braingeneers/picroscope-supplement/CADs/README.md

Here are the .STL files for the picroscope. 
Base x1 
Elevator x1 
limit swtich x1 
camerarow x4 
camera insert x24 
led 1 and led 2 x1 
xystage x1 
picroscope wide x1
