braingeneers/picroscope-supplement/PCBs/README.txt

Power distribution board -> V8
Relay hub -> V3R1 -> JLCPCB
Below light -> V6 -> JLCPCB
Overhead light -> R5 -> PCBWAY
