braingeneers/picroscope-supplement/PCBs/below_light/v6/jlc_bom.csv

Comment | Designator | Footprint | LCSC Part #（optional）
LED | LED5 | CHIP-LED0603 | C389521
LED | LED6 | CHIP-LED0603 | C389521
LED | LED7 | CHIP-LED0603 | C389521
LED | LED8 | CHIP-LED0603 | C389521
LED | LED9 | CHIP-LED0603 | C389521
LED | LED10 | CHIP-LED0603 | C389521
LED | LED11 | CHIP-LED0603 | C389521
LED | LED12 | CHIP-LED0603 | C389521
LED | LED13 | CHIP-LED0603 | C389521
LED | LED14 | CHIP-LED0603 | C389521
LED | LED15 | CHIP-LED0603 | C389521
LED | LED16 | CHIP-LED0603 | C389521
LED | LED17 | CHIP-LED0603 | C389521
LED | LED18 | CHIP-LED0603 | C389521
LED | LED19 | CHIP-LED0603 | C389521
LED | LED20 | CHIP-LED0603 | C389521
LED | LED21 | CHIP-LED0603 | C389521
LED | LED22 | CHIP-LED0603 | C389521
LED | LED23 | CHIP-LED0603 | C389521
LED | LED24 | CHIP-LED0603 | C389521
LED | LED25 | CHIP-LED0603 | C389521
LED | LED26 | CHIP-LED0603 | C389521
LED | LED27 | CHIP-LED0603 | C389521
LED | LED28 | CHIP-LED0603 | C389521
LED | LED29 | CHIP-LED0603 | C389521
LED | LED30 | CHIP-LED0603 | C389521
LED | LED31 | CHIP-LED0603 | C389521
LED | LED32 | CHIP-LED0603 | C389521
LED | LED33 | CHIP-LED0603 | C389521
LED | LED34 | CHIP-LED0603 | C389521
LED | LED35 | CHIP-LED0603 | C389521
LED | LED36 | CHIP-LED0603 | C389521
LED | LED37 | CHIP-LED0603 | C389521
LED | LED38 | CHIP-LED0603 | C389521
LED | LED39 | CHIP-LED0603 | C389521
LED | LED40 | CHIP-LED0603 | C389521
LED | LED45 | CHIP-LED0603 | C389521
LED | LED46 | CHIP-LED0603 | C389521
LED | LED47 | CHIP-LED0603 | C389521
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
Resistor | R400 | R0603 | C22775
Resistor | R405 | R0603 | C22775
Resistor | R406 | R0603 | C22775
Resistor | R407 | R0603 | C22775
Resistor | R408 | R0603 | C22775
Resistor | R413 | R0603 | C22775
Resistor | R414 | R0603 | C22775
Resistor | R415 | R0603 | C22775
Resistor | R416 | R0603 | C22775
