braingeneers/picroscope-supplement/PCBs/encoder_uno_shield/without-debounce-v1.0/jlcpcb-assembly-files/shield board_top_bom.csv

Comment | Designator | Footprint | LCSC Part #
0.1uF | C1 | C0603
1k | R3 | R0603
10k | R4 | R0603
