braingeneers/picroscope-supplement/PCBs/power_distribution/pinheader_v8/PCBWay/Mid/mid_bom.xlsx

 | Column1 | Column12 | Column2 | Column3 | Column4 | Column5
Item# | *Designator | Qty | Manufacturer | *Mfg Part # | *Package/Footprint | Description
1 | C13 | 1 | Nichicon | UHE1E331MPD6 | E3,5-8 | POLARIZED CAPACITOR 330uF, 25V, American symbol
1 | C14 | 1 | Nichicon | UHE1E331MPD6 | E3,5-8 | POLARIZED CAPACITOR 330uF, 25V, American symbol
1 | C15 | 1 | Nichicon | UHE1E331MPD6 | E3,5-8 | POLARIZED CAPACITOR 330uF, 25V, American symbol
1 | C16 | 1 | Nichicon | UHE1E331MPD6 | E3,5-8 | POLARIZED CAPACITOR 330uF, 25V, American symbol
1 | U$1 | 1 | Sullins Connector Solutions | SFH11-PBPC-D20-RA-BK | RASPI_GPIO_B+_PIN | CONN HDR 40POS 0.1 GOLD PCB R/A
1 | U$2 | 1 | Sullins Connector Solutions | SFH11-PBPC-D20-RA-BK | RASPI_GPIO_B+_PIN | CONN HDR 40POS 0.1 GOLD PCB R/A
1 | U$3 | 1 | Sullins Connector Solutions | SFH11-PBPC-D20-RA-BK | RASPI_GPIO_B+_PIN | CONN HDR 40POS 0.1 GOLD PCB R/A
1 | U$4 | 1 | Sullins Connector Solutions | SFH11-PBPC-D20-RA-BK | RASPI_GPIO_B+_PIN | CONN HDR 40POS 0.1 GOLD PCB R/A
1 | U$5 | 1 | Sullins Connector Solutions | SFH11-PBPC-D20-RA-BK | RASPI_GPIO_B+_PIN | CONN HDR 40POS 0.1 GOLD PCB R/A
1 | U$6 | 1 | Sullins Connector Solutions | SFH11-PBPC-D20-RA-BK | RASPI_GPIO_B+_PIN | CONN HDR 40POS 0.1 GOLD PCB R/A
1 | U$7 | 1 | Sullins Connector Solutions | SFH11-PBPC-D20-RA-BK | RASPI_GPIO_B+_PIN | CONN HDR 40POS 0.1 GOLD PCB R/A
1 | U$8 | 1 | Sullins Connector Solutions | SFH11-PBPC-D20-RA-BK | RASPI_GPIO_B+_PIN | CONN HDR 40POS 0.1 GOLD PCB R/A
1 | U$9 | 1 | Sullins Connector Solutions | SFH11-PBPC-D20-RA-BK | RASPI_GPIO_B+_PIN | CONN HDR 40POS 0.1 GOLD PCB R/A
1 | U$10 | 1 | Sullins Connector Solutions | SFH11-PBPC-D20-RA-BK | RASPI_GPIO_B+_PIN | CONN HDR 40POS 0.1 GOLD PCB R/A
1 | U$11 | 1 | Sullins Connector Solutions | SFH11-PBPC-D20-RA-BK | RASPI_GPIO_B+_PIN | CONN HDR 40POS 0.1 GOLD PCB R/A
1 | U$12 | 1 | Sullins Connector Solutions | SFH11-PBPC-D20-RA-BK | RASPI_GPIO_B+_PIN | CONN HDR 40POS 0.1 GOLD PCB R/A
1 | U$13 | 1 | MOLEX | 39301022 | MINI-FIT_JR_CONN
1 | U$14 | 1 | MOLEX | 39301022 | MINI-FIT_JR_CONN
1 | U$15 | 1 | MOLEX | 39301022 | MINI-FIT_JR_CONN
1 | U$16 | 1 | MOLEX | 39301022 | MINI-FIT_JR_CONN
