braingeneers/picroscope-supplement/PCBs/pi_relay_hub/v3r2/picrocope_hub_v3r2.csv

C1 | 54.48 | 27.81 | 0 | 0.1uF | C0603
C2 | 28.84 | 38.13 | 270 | 47 uF | C1210
C3 | 58.29 | 27.81 | 0 | 0.1uF | C0603
C4 | 46.46 | 24.04 | 270 | 47 uF | C1210
C5 | 28.68 | 24.13 | 270 | 47 uF | C1210
C6 | 28.70 | 30.48 | 0 | 100pF | C0603
C7 | 46.49 | 38.17 | 270 | 47 uF | C1210
C8 | 28.96 | 44.45 | 0 | 100pF | C0603
C9 | 46.48 | 9.53 | 270 | 47 uF | C1210
C10 | 28.83 | 9.53 | 270 | 47 uF | C1210
C11 | 28.83 | 15.75 | 0 | 100pF | C0603
D1 | -16.26 | 45.97 | 270 | 1N4148 | LL-34
D2 | 5.33 | 45.97 | 270 | 1N4148 | LL-34
D3 | -26.42 | 45.97 | 270 | 1N4148 | LL-34
D4 | -37.85 | 45.97 | 270 | 1N4148 | LL-34
D5 | -6.10 | 45.97 | 270 | 1N4148 | LL-34
D6 | 16.76 | 45.97 | 270 | 1N4148 | LL-34
Q1 | 9.14 | 46.02 | 0 | 600mA/40V | SOT23-3
Q2 | -12.45 | 46.02 | 0 | 600mA/40V | SOT23-3
Q3 | -22.61 | 46.02 | 0 | 600mA/40V | SOT23-3
Q4 | -34.04 | 46.02 | 0 | 600mA/40V | SOT23-3
Q5 | -2.29 | 46.02 | 0 | 600mA/40V | SOT23-3
Q6 | 20.57 | 46.02 | 0 | 600mA/40V | SOT23-3
R1 | 9.14 | 42.16 | 180 | 1k | R0603
R2 | -12.45 | 42.16 | 180 | 1k | R0603
R3 | -22.61 | 42.16 | 180 | 1k | R0603
R4 | -34.04 | 42.16 | 180 | 1k | R0603
R5 | 54.48 | 23.75 | 180 | 1k | R0603
R6 | 54.48 | 25.78 | 0 | 10k | R0603
R7 | 28.96 | 46.99 | 0 | 2.727k | R0603
R8 | 28.70 | 33.02 | 0 | 2.727k | R0603
R9 | 58.29 | 23.75 | 180 | 1k | R0603
R10 | 58.29 | 25.78 | 0 | 10k | R0603
R11 | -2.29 | 42.16 | 180 | 1k | R0603
R12 | 28.67 | 28.03 | 0 | 330 | R0603
R13 | 28.96 | 42.16 | 0 | 330 | R0603
R14 | 20.57 | 42.16 | 180 | 1k | R0603
R15 | 28.83 | 18.29 | 0 | 2.727k | R0603
R16 | 28.83 | 13.46 | 0 | 330 | R0603
TP1 | 26.16 | 10.92 | 0 | PTR1B1 | 27 | B1 | 27
TP2 | 25.91 | 27.69 | 0 | PTR1B1 | 27 | B1 | 27
TP3 | 26.16 | 39.62 | 0 | PTR1B1 | 27 | B1 | 27
TP4 | 52.07 | 29.46 | 0 | PTR1B1 | 27 | B1 | 27
U$1 | 37.74 | 41.74 | 180 | PVX012A0XV1 | PVX012A0X
U$2 | 37.51 | 27.75 | 180 | PVX012A0XV1 | PVX012A0X
U$4 | 37.46 | 13.08 | 180 | PVX012A0XV1 | PVX012A0X
U$10 | 46.43 | 31.09 | 270 | PTC_1206 | 1206
U$11 | 46.44 | 44.66 | 270 | PTC_1206 | 1206
U$17 | 46.48 | 16.76 | 270 | PTC_1206 | 1206
