braingeneers/picroscope-supplement/PCBs/overhead_light/r5_cleanup_updated_file/24v5_bom.xlsx

Item # | *Designator | *Qty | Manufacturer | *Mfg Part # | Description / Value | *Package/Footprint | Type | Your Instructions / Notes
1 | C1 |  |  |  | 47 uF | C1210 | SMD
2 | C7 |  |  |  | 47 uF | C1210 | SMD
3 | R3 |  |  |  | 4k | R0603 | SMD
4 | RJ1 |  |  |  | 5k | 3223W | SMD
5 | U$1 |  | Chanzon | 10DGL-DZ-3W-WH | high_powered_led_packages__pcb_3w-_100w_arrays |  | SMD | https://www.amazon.com/gp/product/B01DBZICDC/ref=ppx_yo_dt_b_search_asin_title?ie=UTF8&th=1
6 | U$2 |  | Chanzon | 10DGL-DZ-3W-WH | high_powered_led_packages__pcb_3w-_100w_arrays |  | SMD | https://www.amazon.com/gp/product/B01DBZICDC/ref=ppx_yo_dt_b_search_asin_title?ie=UTF8&th=1
7 | U$3 |  | Chanzon | 10DGL-DZ-3W-WH | high_powered_led_packages__pcb_3w-_100w_arrays |  | SMD | https://www.amazon.com/gp/product/B01DBZICDC/ref=ppx_yo_dt_b_search_asin_title?ie=UTF8&th=1
8 | U$4 |  | Chanzon | 10DGL-DZ-3W-WH | high_powered_led_packages__pcb_3w-_100w_arrays |  | SMD | https://www.amazon.com/gp/product/B01DBZICDC/ref=ppx_yo_dt_b_search_asin_title?ie=UTF8&th=1
9 | U$5 |  | Chanzon | 10DGL-DZ-3W-WH | high_powered_led_packages__pcb_3w-_100w_arrays |  | SMD | https://www.amazon.com/gp/product/B01DBZICDC/ref=ppx_yo_dt_b_search_asin_title?ie=UTF8&th=1
10 | U$6 |  | Chanzon | 10DGL-DZ-3W-WH | high_powered_led_packages__pcb_3w-_100w_arrays |  | SMD | https://www.amazon.com/gp/product/B01DBZICDC/ref=ppx_yo_dt_b_search_asin_title?ie=UTF8&th=1
11 | U$7 |  | Chanzon | 10DGL-DZ-3W-WH | high_powered_led_packages__pcb_3w-_100w_arrays |  | SMD | https://www.amazon.com/gp/product/B01DBZICDC/ref=ppx_yo_dt_b_search_asin_title?ie=UTF8&th=1
12 | U$8 |  | Chanzon | 10DGL-DZ-3W-WH | high_powered_led_packages__pcb_3w-_100w_arrays |  | SMD | https://www.amazon.com/gp/product/B01DBZICDC/ref=ppx_yo_dt_b_search_asin_title?ie=UTF8&th=1
13 | U$9 |  | Chanzon | 10DGL-DZ-3W-WH | high_powered_led_packages__pcb_3w-_100w_arrays |  | SMD | https://www.amazon.com/gp/product/B01DBZICDC/ref=ppx_yo_dt_b_search_asin_title?ie=UTF8&th=1
14 | U$10 |  | Chanzon | 10DGL-DZ-3W-WH | high_powered_led_packages__pcb_3w-_100w_arrays |  | SMD | https://www.amazon.com/gp/product/B01DBZICDC/ref=ppx_yo_dt_b_search_asin_title?ie=UTF8&th=1
15 | U$11 |  | Chanzon | 10DGL-DZ-3W-WH | high_powered_led_packages__pcb_3w-_100w_arrays |  | SMD | https://www.amazon.com/gp/product/B01DBZICDC/ref=ppx_yo_dt_b_search_asin_title?ie=UTF8&th=1
16 | U$12 |  | Chanzon | 10DGL-DZ-3W-WH | high_powered_led_packages__pcb_3w-_100w_arrays |  | SMD | https://www.amazon.com/gp/product/B01DBZICDC/ref=ppx_yo_dt_b_search_asin_title?ie=UTF8&th=1
17 | U$13 |  | Chanzon | 10DGL-DZ-3W-WH | high_powered_led_packages__pcb_3w-_100w_arrays |  | SMD | https://www.amazon.com/gp/product/B01DBZICDC/ref=ppx_yo_dt_b_search_asin_title?ie=UTF8&th=1
18 | U$14 |  | Chanzon | 10DGL-DZ-3W-WH | high_powered_led_packages__pcb_3w-_100w_arrays |  | SMD | https://www.amazon.com/gp/product/B01DBZICDC/ref=ppx_yo_dt_b_search_asin_title?ie=UTF8&th=1
19 | U$15 |  | Chanzon | 10DGL-DZ-3W-WH | high_powered_led_packages__pcb_3w-_100w_arrays |  | SMD | https://www.amazon.com/gp/product/B01DBZICDC/ref=ppx_yo_dt_b_search_asin_title?ie=UTF8&th=1
20 | U$16 |  | Chanzon | 10DGL-DZ-3W-WH | high_powered_led_packages__pcb_3w-_100w_arrays |  | SMD | https://www.amazon.com/gp/product/B01DBZICDC/ref=ppx_yo_dt_b_search_asin_title?ie=UTF8&th=1
21 | U$17 |  | Chanzon | 10DGL-DZ-3W-WH | high_powered_led_packages__pcb_3w-_100w_arrays |  | SMD | https://www.amazon.com/gp/product/B01DBZICDC/ref=ppx_yo_dt_b_search_asin_title?ie=UTF8&th=1
22 | U$18 |  | Chanzon | 10DGL-DZ-3W-WH | high_powered_led_packages__pcb_3w-_100w_arrays |  | SMD | https://www.amazon.com/gp/product/B01DBZICDC/ref=ppx_yo_dt_b_search_asin_title?ie=UTF8&th=1
23 | U$19 |  | Chanzon | 10DGL-DZ-3W-WH | high_powered_led_packages__pcb_3w-_100w_arrays |  | SMD | https://www.amazon.com/gp/product/B01DBZICDC/ref=ppx_yo_dt_b_search_asin_title?ie=UTF8&th=1
24 | U$20 |  | Chanzon | 10DGL-DZ-3W-WH | high_powered_led_packages__pcb_3w-_100w_arrays |  | SMD | https://www.amazon.com/gp/product/B01DBZICDC/ref=ppx_yo_dt_b_search_asin_title?ie=UTF8&th=1
25 | U$21 |  | Chanzon | 10DGL-DZ-3W-WH | high_powered_led_packages__pcb_3w-_100w_arrays |  | SMD | https://www.amazon.com/gp/product/B01DBZICDC/ref=ppx_yo_dt_b_search_asin_title?ie=UTF8&th=1
26 | U$22 |  | Chanzon | 10DGL-DZ-3W-WH | high_powered_led_packages__pcb_3w-_100w_arrays |  | SMD | https://www.amazon.com/gp/product/B01DBZICDC/ref=ppx_yo_dt_b_search_asin_title?ie=UTF8&th=1
27 | U$23 |  | Chanzon | 10DGL-DZ-3W-WH | high_powered_led_packages__pcb_3w-_100w_arrays |  | SMD | https://www.amazon.com/gp/product/B01DBZICDC/ref=ppx_yo_dt_b_search_asin_title?ie=UTF8&th=1
28 | U$24 |  | Chanzon | 10DGL-DZ-3W-WH | high_powered_led_packages__pcb_3w-_100w_arrays |  | SMD | https://www.amazon.com/gp/product/B01DBZICDC/ref=ppx_yo_dt_b_search_asin_title?ie=UTF8&th=1
29 | U$25 |  | ABB Power Electronics Inc. | PVX012A0X3-SRZ | DC DC CONVERTER 0.6-5.5V 66W | 17-SMD Module | SMD | https://www.digikey.com/en/products/detail/abb-power-electronics-inc/PVX012A0X3-SRZ/2601261
