braingeneers/picroscope-supplement/CADs/camera_holder/camera_holder_middle_left.stl

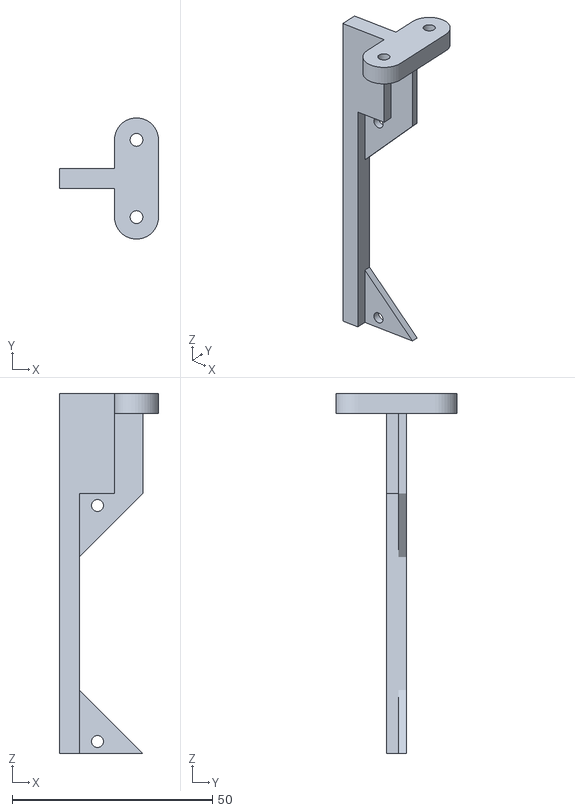
[picture p1: CAD file, 2022-08-23]
CADs/camera_holder/camera_holder_middle_left.stl
24.8 x 30.3 x 90.0
