braingeneers/picroscope-supplement/CADs/limitswitch_front.stl

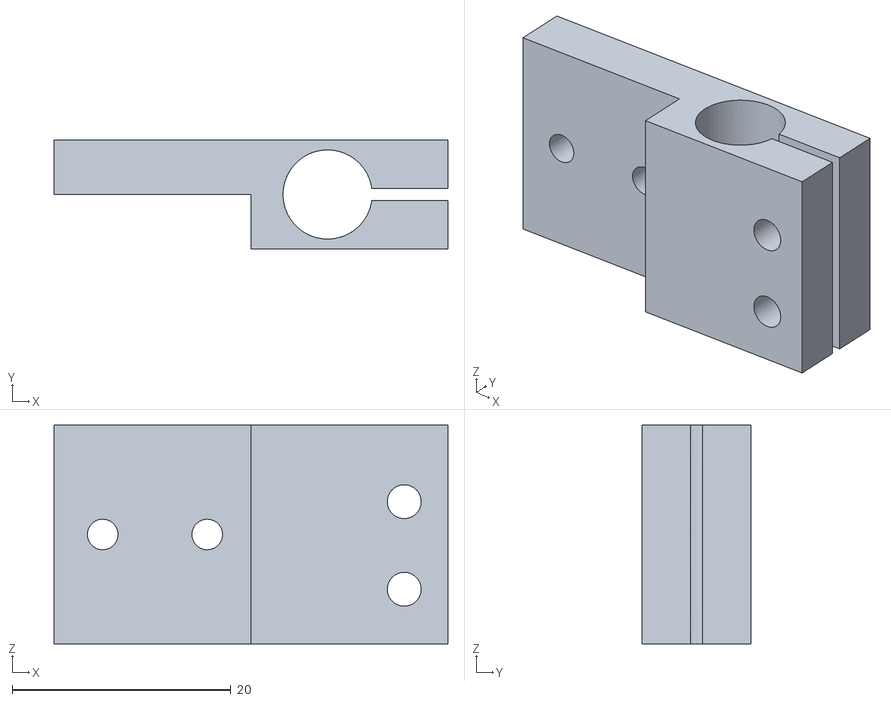
[picture p2: CAD file, 2022-08-23]
CADs/limitswitch_front.stl
36.0 x 10.0 x 20.0
