braingeneers/picroscope-supplement/CADs/XY_stage/XY_Y_axis_adjust.stl

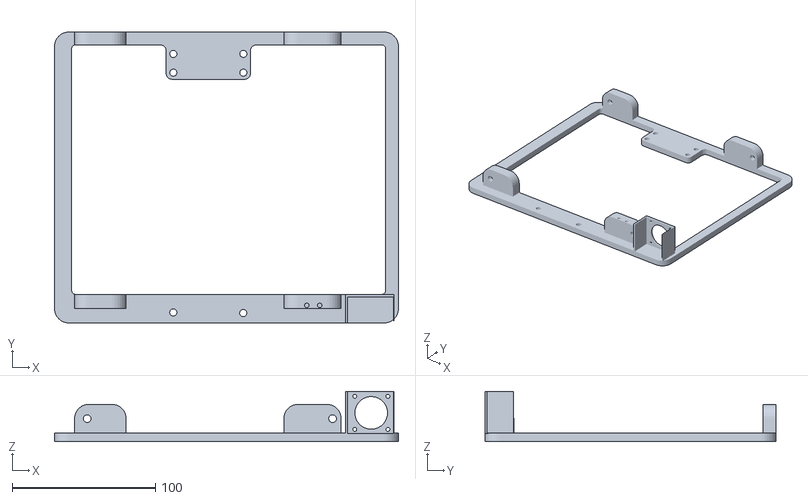
[picture p3: CAD file, 2022-08-23]
CADs/XY_stage/XY_Y_axis_adjust.stl
240.0 x 203.0 x 35.0
