braingeneers/picroscope-supplement/CADs/camera_holder/camera_holder_left.stl

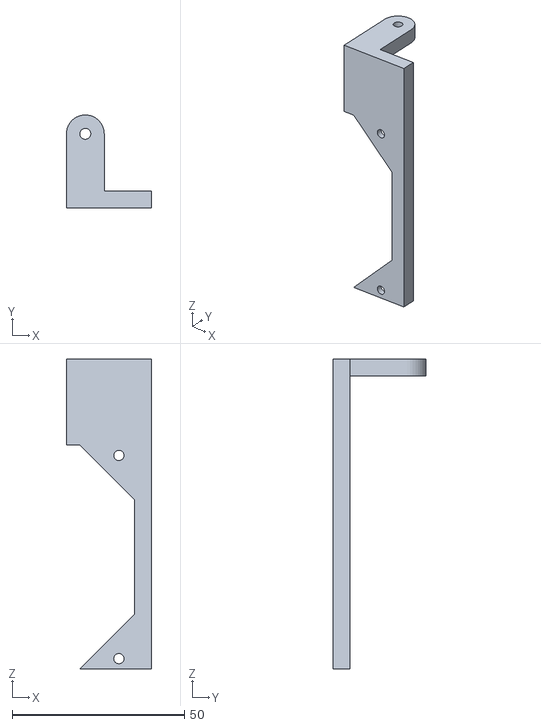
[picture p4: CAD file, 2022-08-23]
CADs/camera_holder/camera_holder_left.stl
24.8 x 27.0 x 90.0
