braingeneers/picroscope-supplement/CADs/Elevator.stl

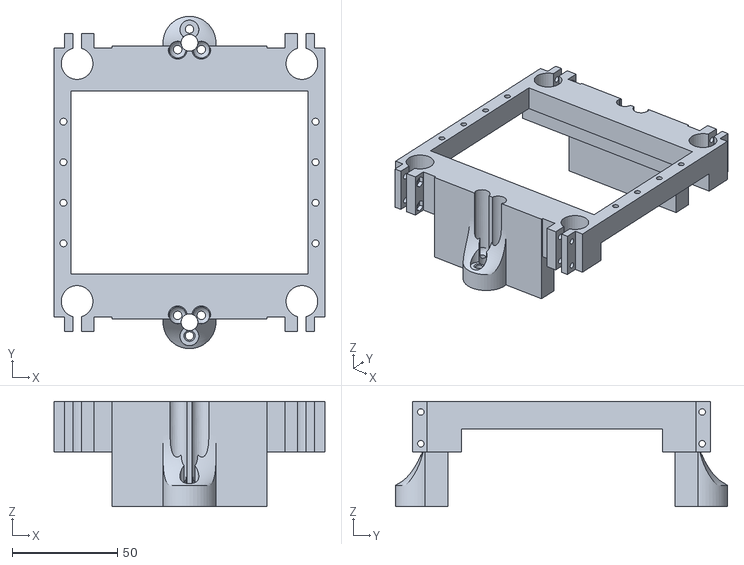
[picture p5: CAD file, 2022-08-23]
CADs/Elevator.stl
129.0 x 158.2 x 50.0
