braingeneers/picroscope-supplement/CADs/XY_stage/XY_X_axis_adjust.stl

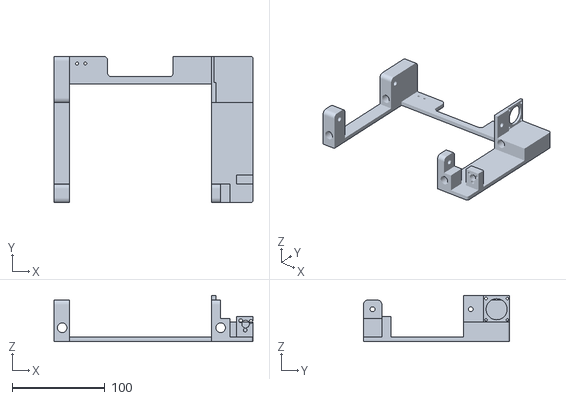
[picture p6: CAD file, 2022-08-23]
CADs/XY_stage/XY_X_axis_adjust.stl
215.0 x 158.0 x 50.0
