braingeneers/picroscope-supplement/CADs/base_linear.stl

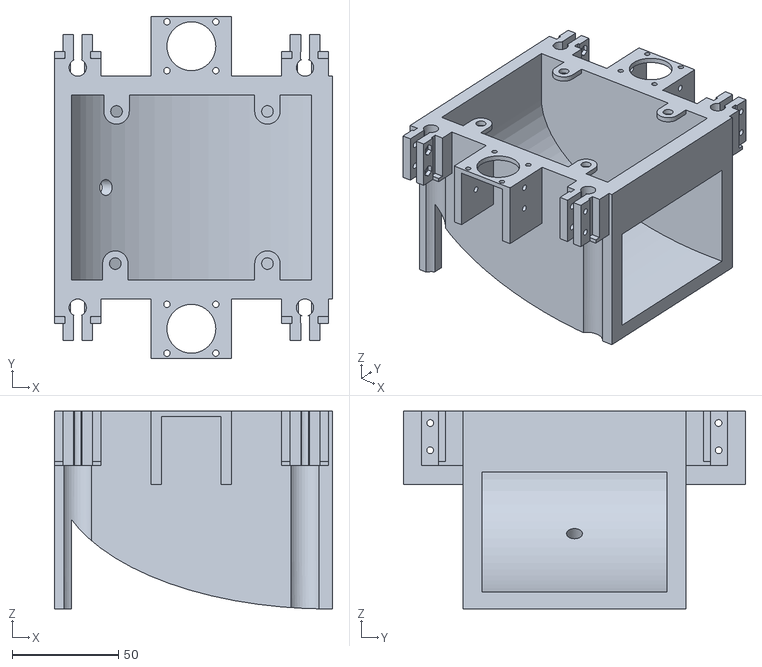
[picture p7: CAD file, 2022-08-23]
CADs/base_linear.stl
131.0 x 161.0 x 93.1
