braingeneers/picroscope-supplement/CADs/XY_stage/XY_plate_holder.stl

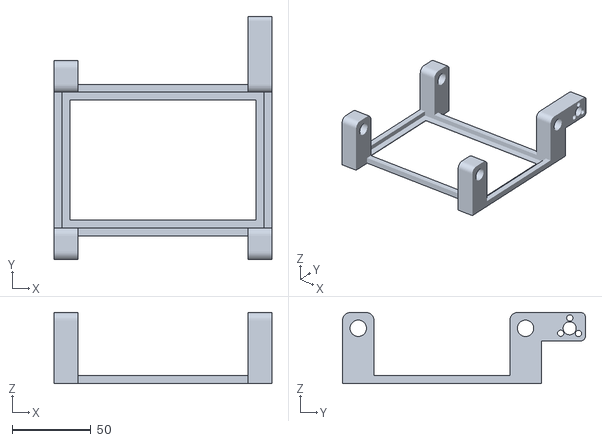
[picture p8: CAD file, 2022-08-23]
CADs/XY_stage/XY_plate_holder.stl
138.0 x 154.0 x 45.0
