braingeneers/picroscope-supplement/CADs/camera_clip.stl

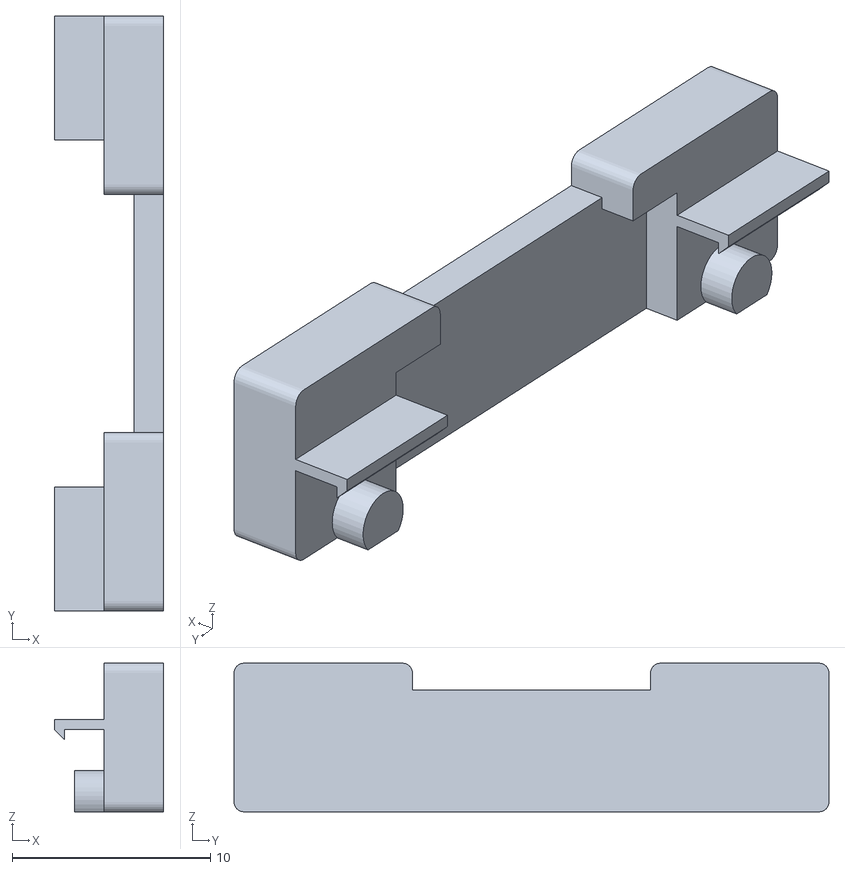
[picture p9: CAD file, 2022-08-23]
CADs/camera_clip.stl
5.50 x 30.0 x 7.50
