braingeneers/picroscope-supplement/CADs/limitswitch_back.stl

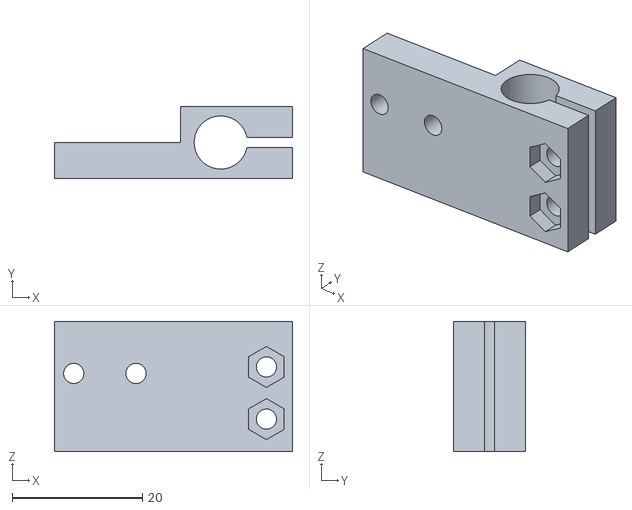
[picture p10: CAD file, 2022-08-23]
CADs/limitswitch_back.stl
36.5 x 11.0 x 20.0
