braingeneers/picroscope-supplement/CADs/picroscopehat.stl

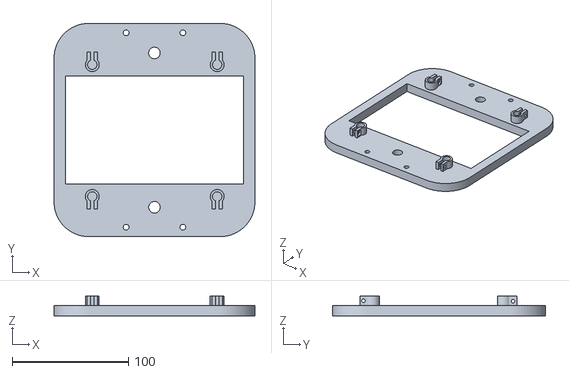
[picture p11: CAD file, 2022-08-23]
CADs/picroscopehat.stl
173.0 x 183.5 x 17.0
