braingeneers/picroscope-supplement/CADs/camerarow1.stl

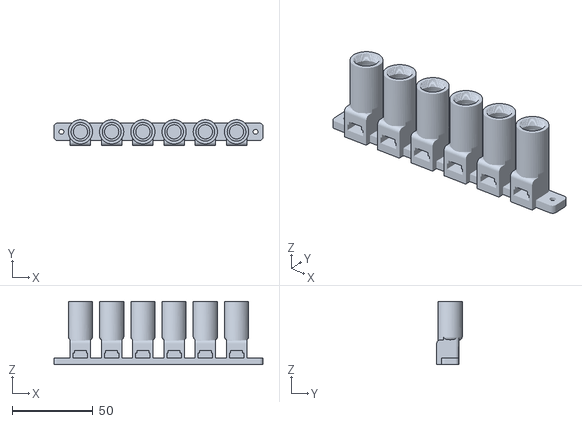
[picture p12: CAD file, 2021-12-13]
CADs/camerarow1.stl
129.2 x 15.8 x 39.2
