braingeneers/picroscope-supplement/CADs/CameraInsert_v24 v1.stl

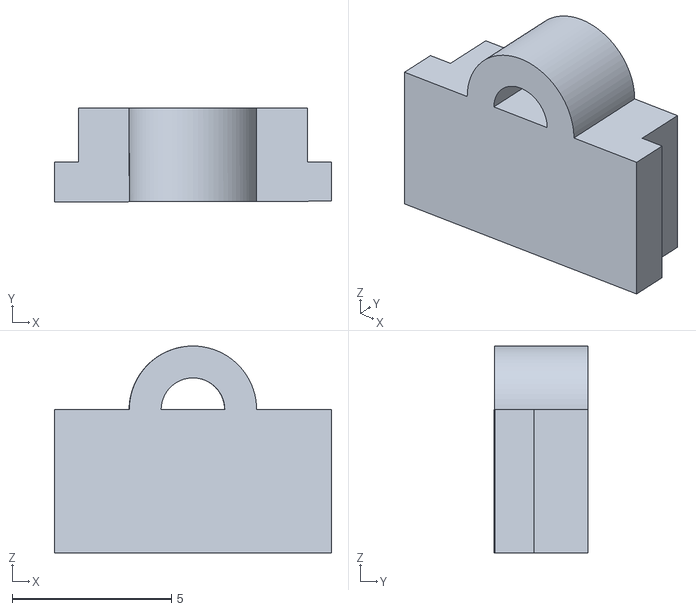
[picture p13: CAD file, 2021-12-13]
CADs/CameraInsert_v24 v1.stl
8.70 x 2.95 x 6.50
