braingeneers/picroscope-supplement/(list of files, cad)

Other CAD files:
CADs/camera_holder/camera_holder_right.stl
CADs/camera_holder/camera_holder_middle_right.stl
