braingeneers/picroscope-supplement/PCBs/power_distribution/pinheader_v8/PCBWay/Mid/assembly_instruction.docx

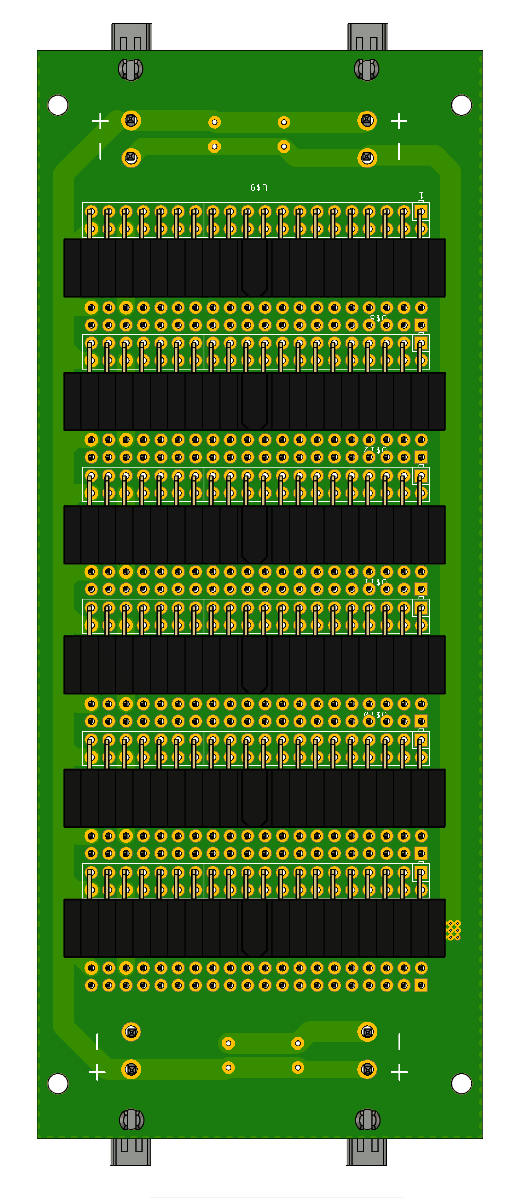
[picture p14: figure]
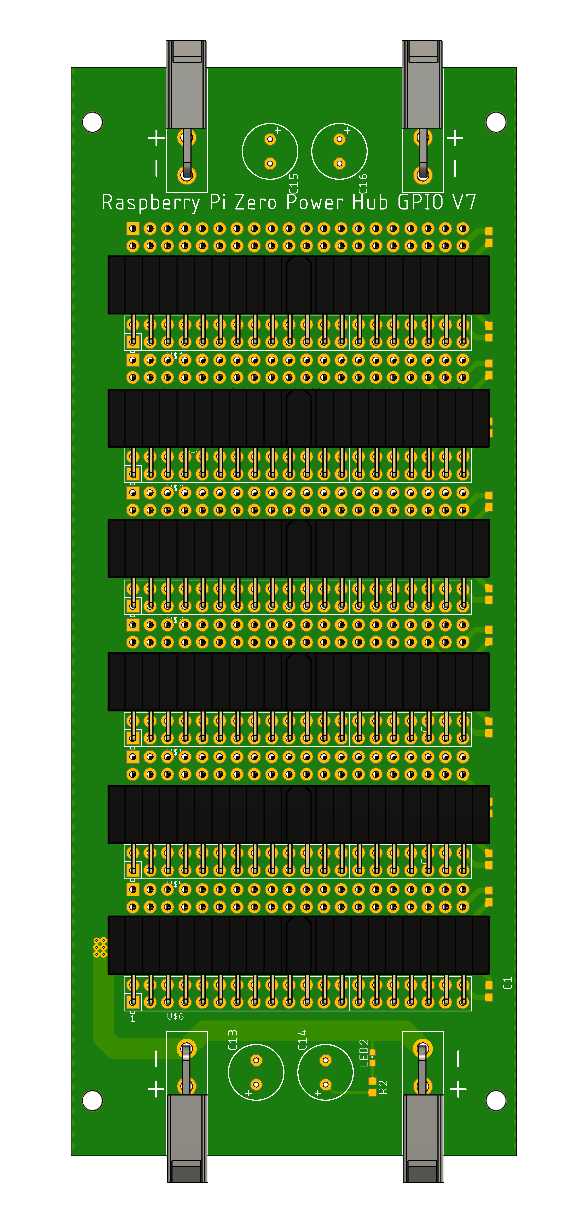
[picture p15: figure]

Top Bottom

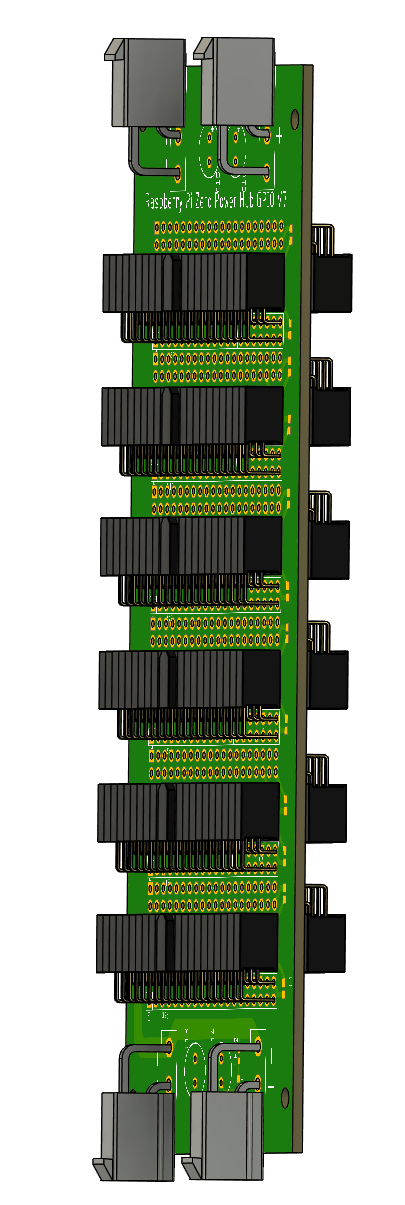
[picture p16: figure]
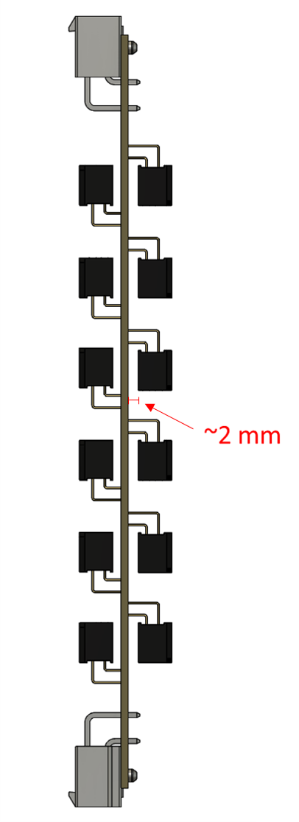
[picture p17: figure]

Side#2 Side#1

Make sure that the connectors sit ~2mm above the surface of a PCB
