braingeneers/picroscope-supplement/PCBs/encoder_uno_shield/without-debounce-v1.0/shield board.brd

## EAGLE design PCBs/encoder_uno_shield/without-debounce-v1.0/shield board.brd (2022-08-23)

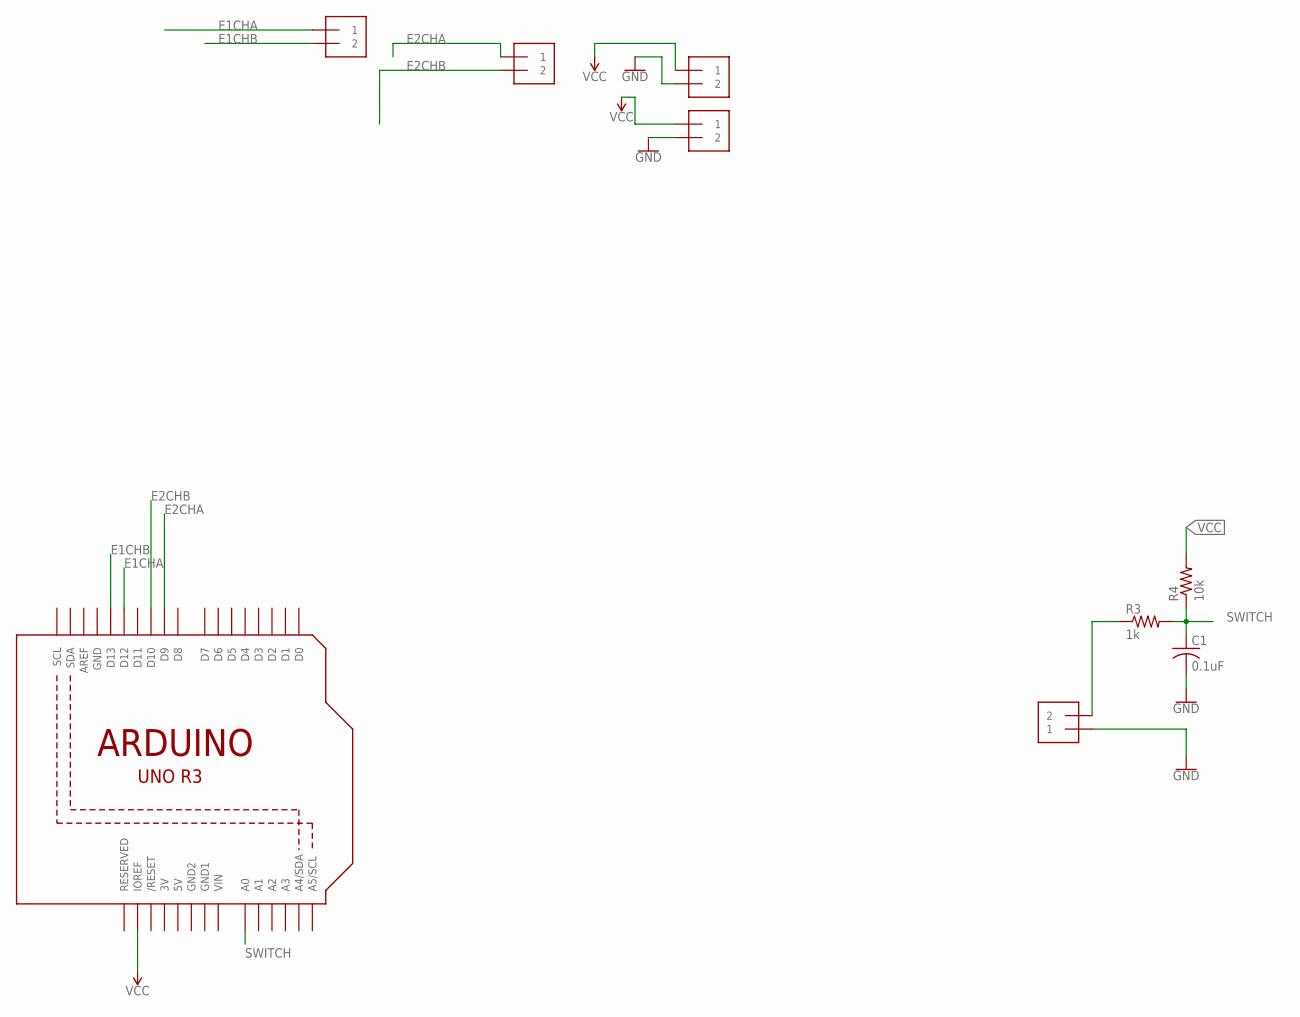
[picture p18: schematic shield board.sch]

Parts:
C1: 0.1uF; C0603
R3: 1k; R0603
R4: 10k; R0603
U1: ARDUINOR3-BPLACE
U$2, U$3, U$4, U$5, U$6: MOLEX_0039301022; MINI-FIT_JR_CONN

Connections:
3V: U1.3V
E1CHA: U1.D12, U$5.P$2 (1)
E1CHB: U1.D13, U$5.P$1 (2)
E2CHA: U1.D9, U$6.P$2 (1)
E2CHB: U1.D10, U$6.P$1 (2)
GND: C1.2, U1.GND, U$2.P$2 (1), U$3.P$1 (2), U$4.P$1 (2)
GND1: U1.GND1
GND2: U1.GND2
unnamed: R3.1, U$2.P$1 (2)
SWITCH: C1.1, R3.2, R4.1, U1.A0
VCC: R4.2, U1.5V, U1.IOREF, U$3.P$2 (1), U$4.P$2 (1)
VIN: U1.VIN

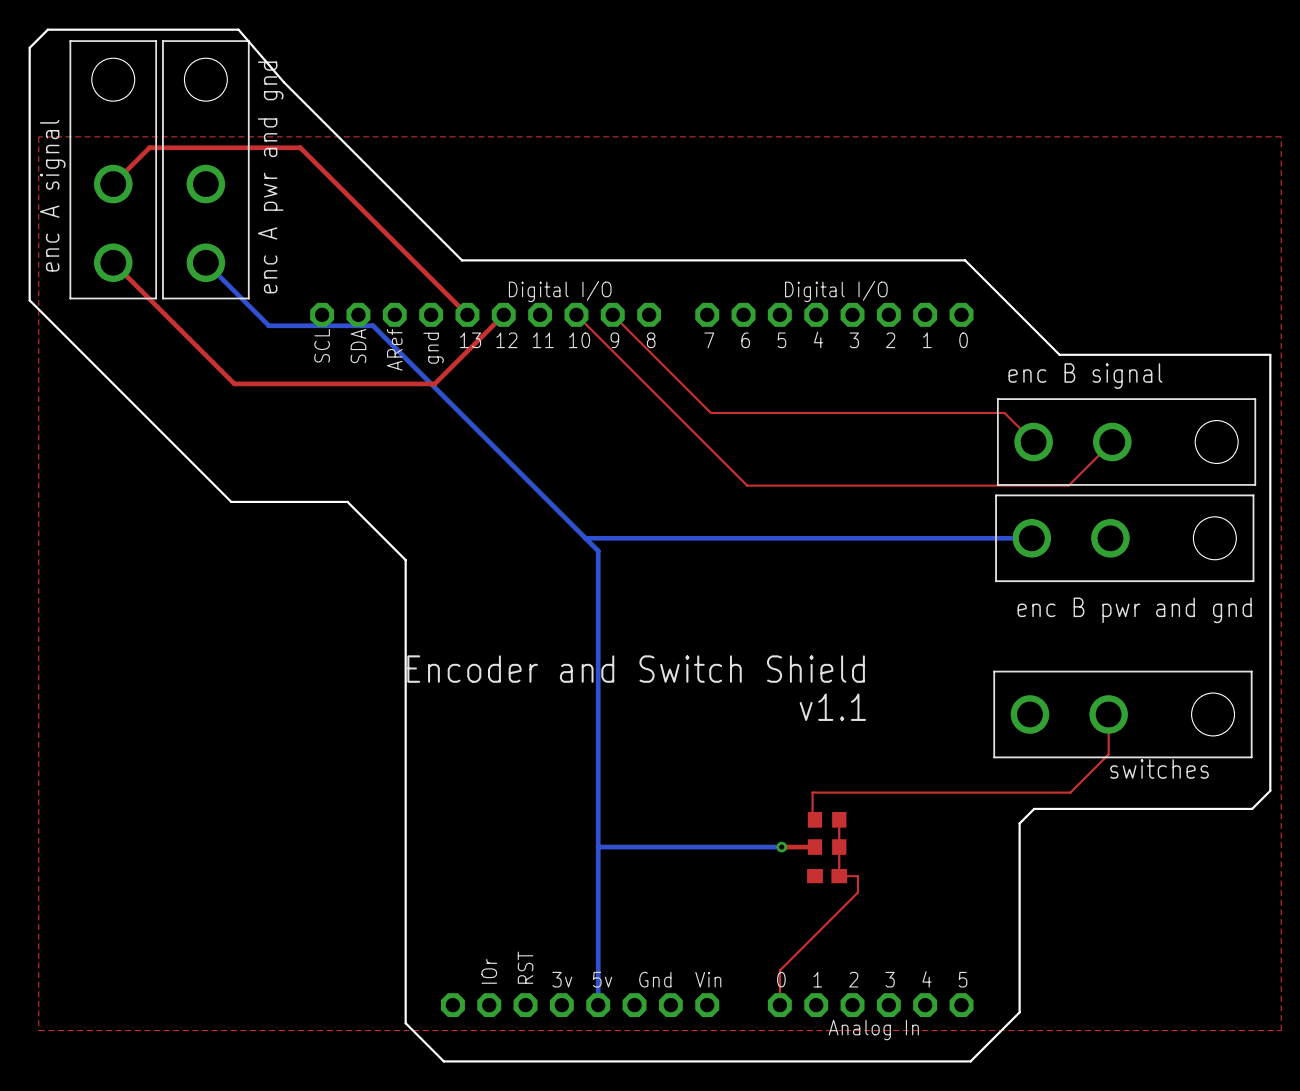
[picture p19: board PCBs/encoder_uno_shield/without-debounce-v1.0/shield board.brd from above]

Board: 2 copper layers, 86.7 x 72.1 mm, 9 parts (0 on the bottom side), 8 nets.
