braingeneers/picroscope-supplement/PCBs/overhead_light/r5_cleanup_updated_file/pannel_24_v5.brd

## EAGLE design PCBs/overhead_light/r5_cleanup_updated_file/pannel_24_v5.brd (2021-11-16)

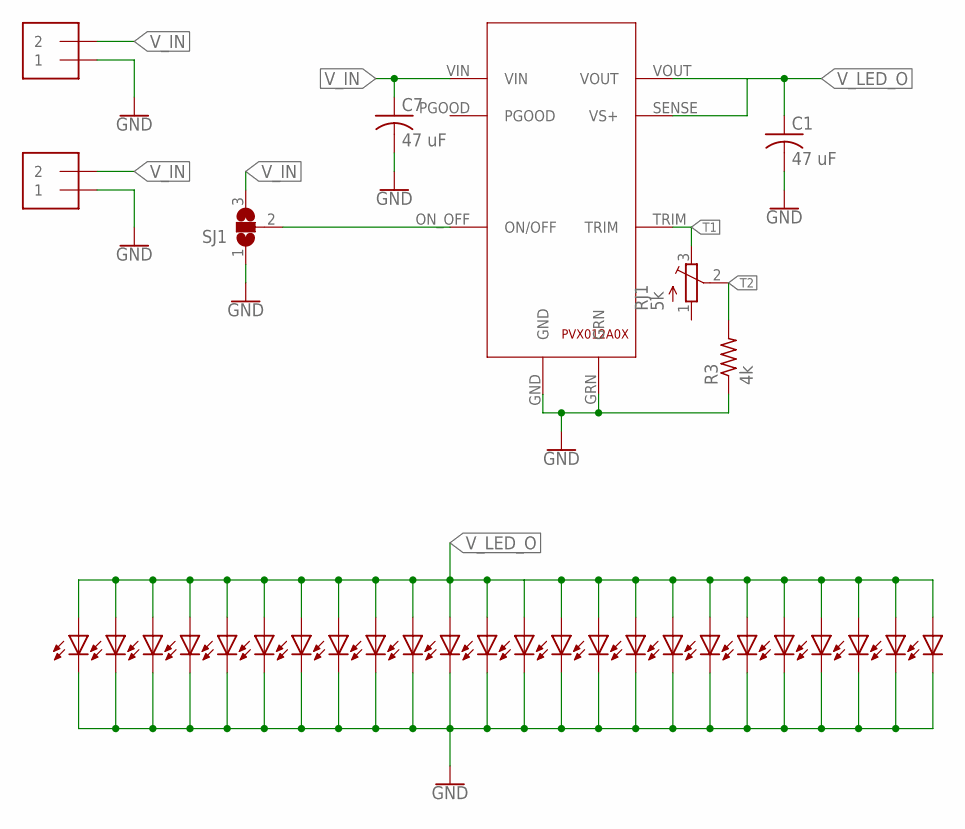
[picture p20: schematic pannel_24_v5.sch]

Parts:
C1, C7: 47 uF; C1210
R3: 4k; R0603
RJ1: 5k; 3223W
SJ1: SJ2W; SJ_2
U$1, U$2, U$3, U$4, U$5, U$6, U$7, U$8, U$9, U$10, U$11, U$12, U$13, U$14, U$15, U$16, U$17, U$18, U$19, U$20, U$21, U$22, U$23, U$24: LED; 3WLED
U$25: PVX012A0XV1; PVX012A0X
U$26, U$27: MOLEX_0039301022; MINI-FIT_JR_CONN

Connections:
GND: C1.2, C7.2, R3.1, SJ1.1, U$1.P$2 (C), U$2.P$2 (C), U$3.P$2 (C), U$4.P$2 (C), U$5.P$2 (C), U$6.P$2 (C), U$7.P$2 (C), U$8.P$2 (C), U$9.P$2 (C), U$10.P$2 (C), U$11.P$2 (C), U$12.P$2 (C), U$13.P$2 (C), U$14.P$2 (C), U$15.P$2 (C), U$16.P$2 (C), U$17.P$2 (C), U$18.P$2 (C), U$19.P$2 (C), U$20.P$2 (C), U$21.P$2 (C), U$22.P$2 (C), U$23.P$2 (C), U$24.P$2 (C), U$25.GND, U$25.GRN, U$26.P$2 (1), U$27.P$2 (1)
ON_OFF: SJ1.2, U$25.ON_OFF (ON/OFF)
T1: RJ1.3 (E), U$25.TRIM
T2: R3.2, RJ1.2 (S)
V_IN: C7.1, SJ1.3, U$25.VIN, U$26.P$1 (2), U$27.P$1 (2)
V_LED_O: C1.1, U$1.P$1 (A), U$2.P$1 (A), U$3.P$1 (A), U$4.P$1 (A), U$5.P$1 (A), U$6.P$1 (A), U$7.P$1 (A), U$8.P$1 (A), U$9.P$1 (A), U$10.P$1 (A), U$11.P$1 (A), U$12.P$1 (A), U$13.P$1 (A), U$14.P$1 (A), U$15.P$1 (A), U$16.P$1 (A), U$17.P$1 (A), U$18.P$1 (A), U$19.P$1 (A), U$20.P$1 (A), U$21.P$1 (A), U$22.P$1 (A), U$23.P$1 (A), U$24.P$1 (A), U$25.SENSE (VS+), U$25.VOUT

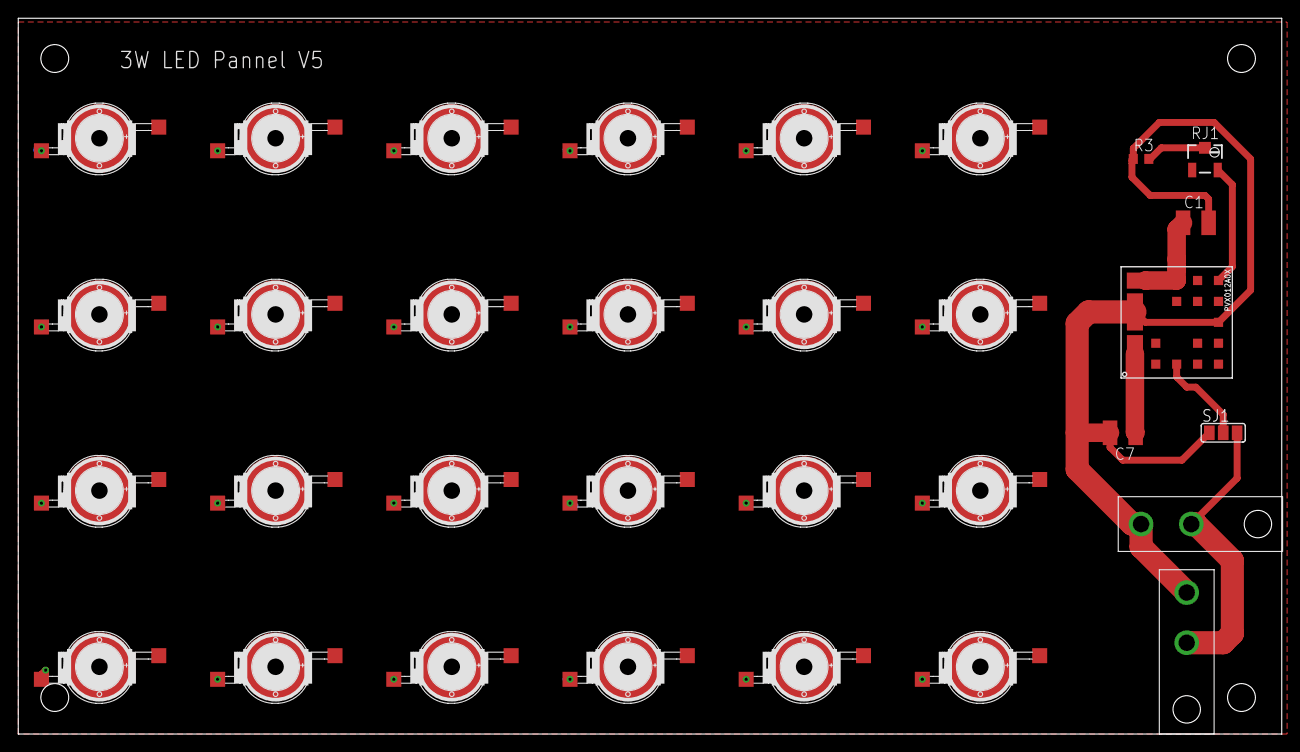
[picture p21: board pannel_24_v5.brd from above]

Board: 2 copper layers, 138.4 x 78.4 mm, 32 parts (0 on the bottom side), 6 nets.
