braingeneers/picroscope-supplement/PCBs/encoder_uno_shield/with-debounce-v1.0/shield board.brd

## EAGLE design PCBs/encoder_uno_shield/with-debounce-v1.0/shield board.brd (2022-03-25)

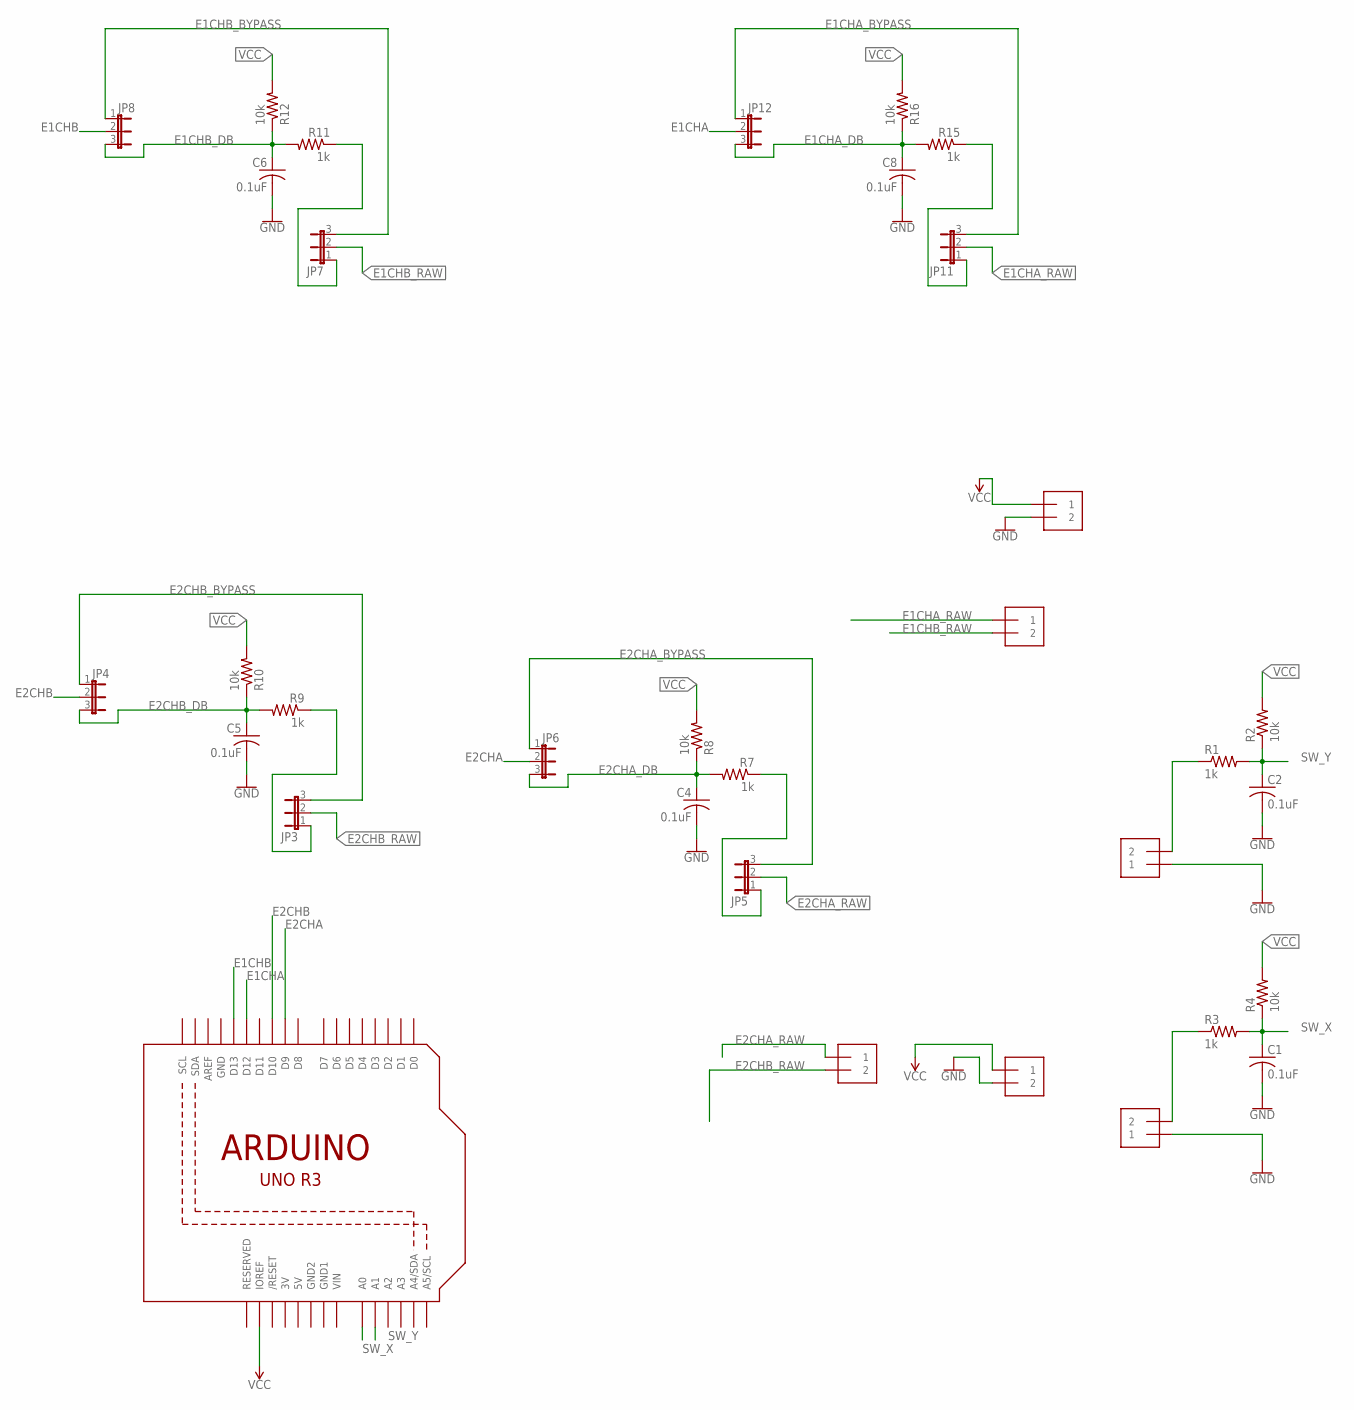
[picture p22: schematic shield board.sch]

Parts:
C1, C2, C4, C5, C6, C8: 0.1uF; C0603
JP3, JP4, JP5, JP6, JP7, JP8, JP11, JP12: JP2E; JP2
R1, R3, R7, R9, R11, R15: 1k; R0603
R2, R4, R8, R10, R12, R16: 10k; R0603
U1: ARDUINOR3-BPLACE
U$1, U$2, U$3, U$4, U$5, U$6: MOLEX_0039301022; MINI-FIT_JR_CONN

Connections:
3V: U1.3V
E1CHA: JP12.2, U1.D12
E1CHA_BYPASS: JP11.3, JP12.1
E1CHA_DB: C8.1, JP12.3, R15.2, R16.1
E1CHA_RAW: JP11.2, U$5.P$2 (1)
E1CHB: JP8.2, U1.D13
E1CHB_BYPASS: JP7.3, JP8.1
E1CHB_DB: C6.1, JP8.3, R11.2, R12.1
E1CHB_RAW: JP7.2, U$5.P$1 (2)
E2CHA: JP6.2, U1.D9
E2CHA_BYPASS: JP5.3, JP6.1
E2CHA_DB: C4.1, JP6.3, R7.2, R8.1
E2CHA_RAW: JP5.2, U$6.P$2 (1)
E2CHB: JP4.2, U1.D10
E2CHB_BYPASS: JP3.3, JP4.1
E2CHB_DB: C5.1, JP4.3, R9.2, R10.1
E2CHB_RAW: JP3.2, U$6.P$1 (2)
GND: C1.2, C2.2, C4.2, C5.2, C6.2, C8.2, U1.GND, U$1.P$2 (1), U$2.P$2 (1), U$3.P$1 (2), U$4.P$1 (2)
GND1: U1.GND1
GND2: U1.GND2
unnamed: R1.1, U$1.P$1 (2)
unnamed: JP5.1, R7.1
unnamed: R3.1, U$2.P$1 (2)
unnamed: JP3.1, R9.1
unnamed: JP7.1, R11.1
unnamed: JP11.1, R15.1
SW_X: C1.1, R3.2, R4.1, U1.A0
SW_Y: C2.1, R1.2, R2.1, U1.A1
VCC: R2.2, R4.2, R8.2, R10.2, R12.2, R16.2, U1.5V, U1.IOREF, U$3.P$2 (1), U$4.P$2 (1)
VIN: U1.VIN

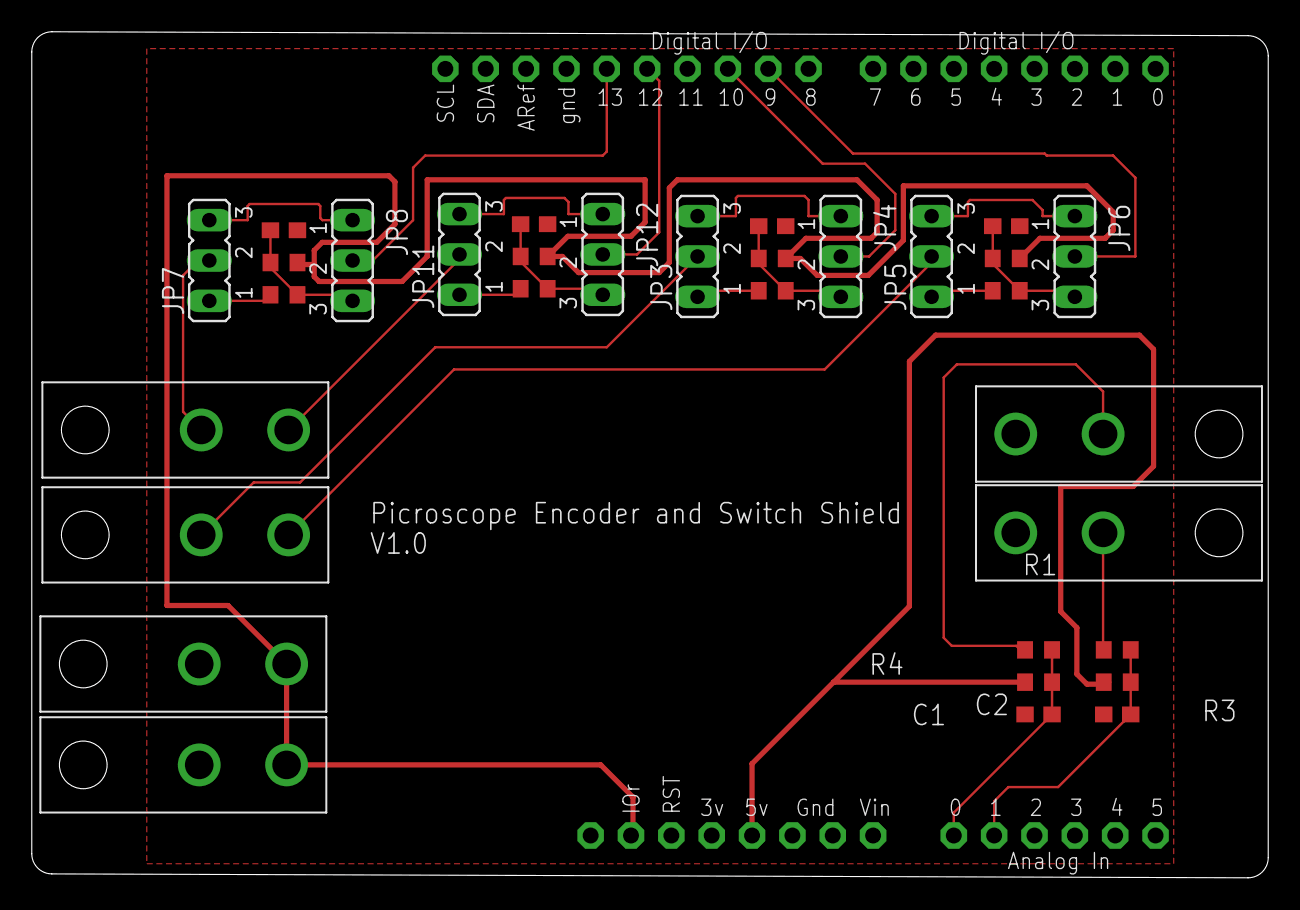
[picture p23: board PCBs/encoder_uno_shield/with-debounce-v1.0/shield board.brd from above]

Board: 2 copper layers, 77.8 x 53.3 mm, 33 parts (0 on the bottom side), 26 nets.
