braingeneers/picroscope-supplement/PCBs/pi_relay_hub/v2r1/picrocope_hub_v2r1.brd

## EAGLE design PCBs/pi_relay_hub/v2r1/picrocope_hub_v2r1.brd (2021-11-16)

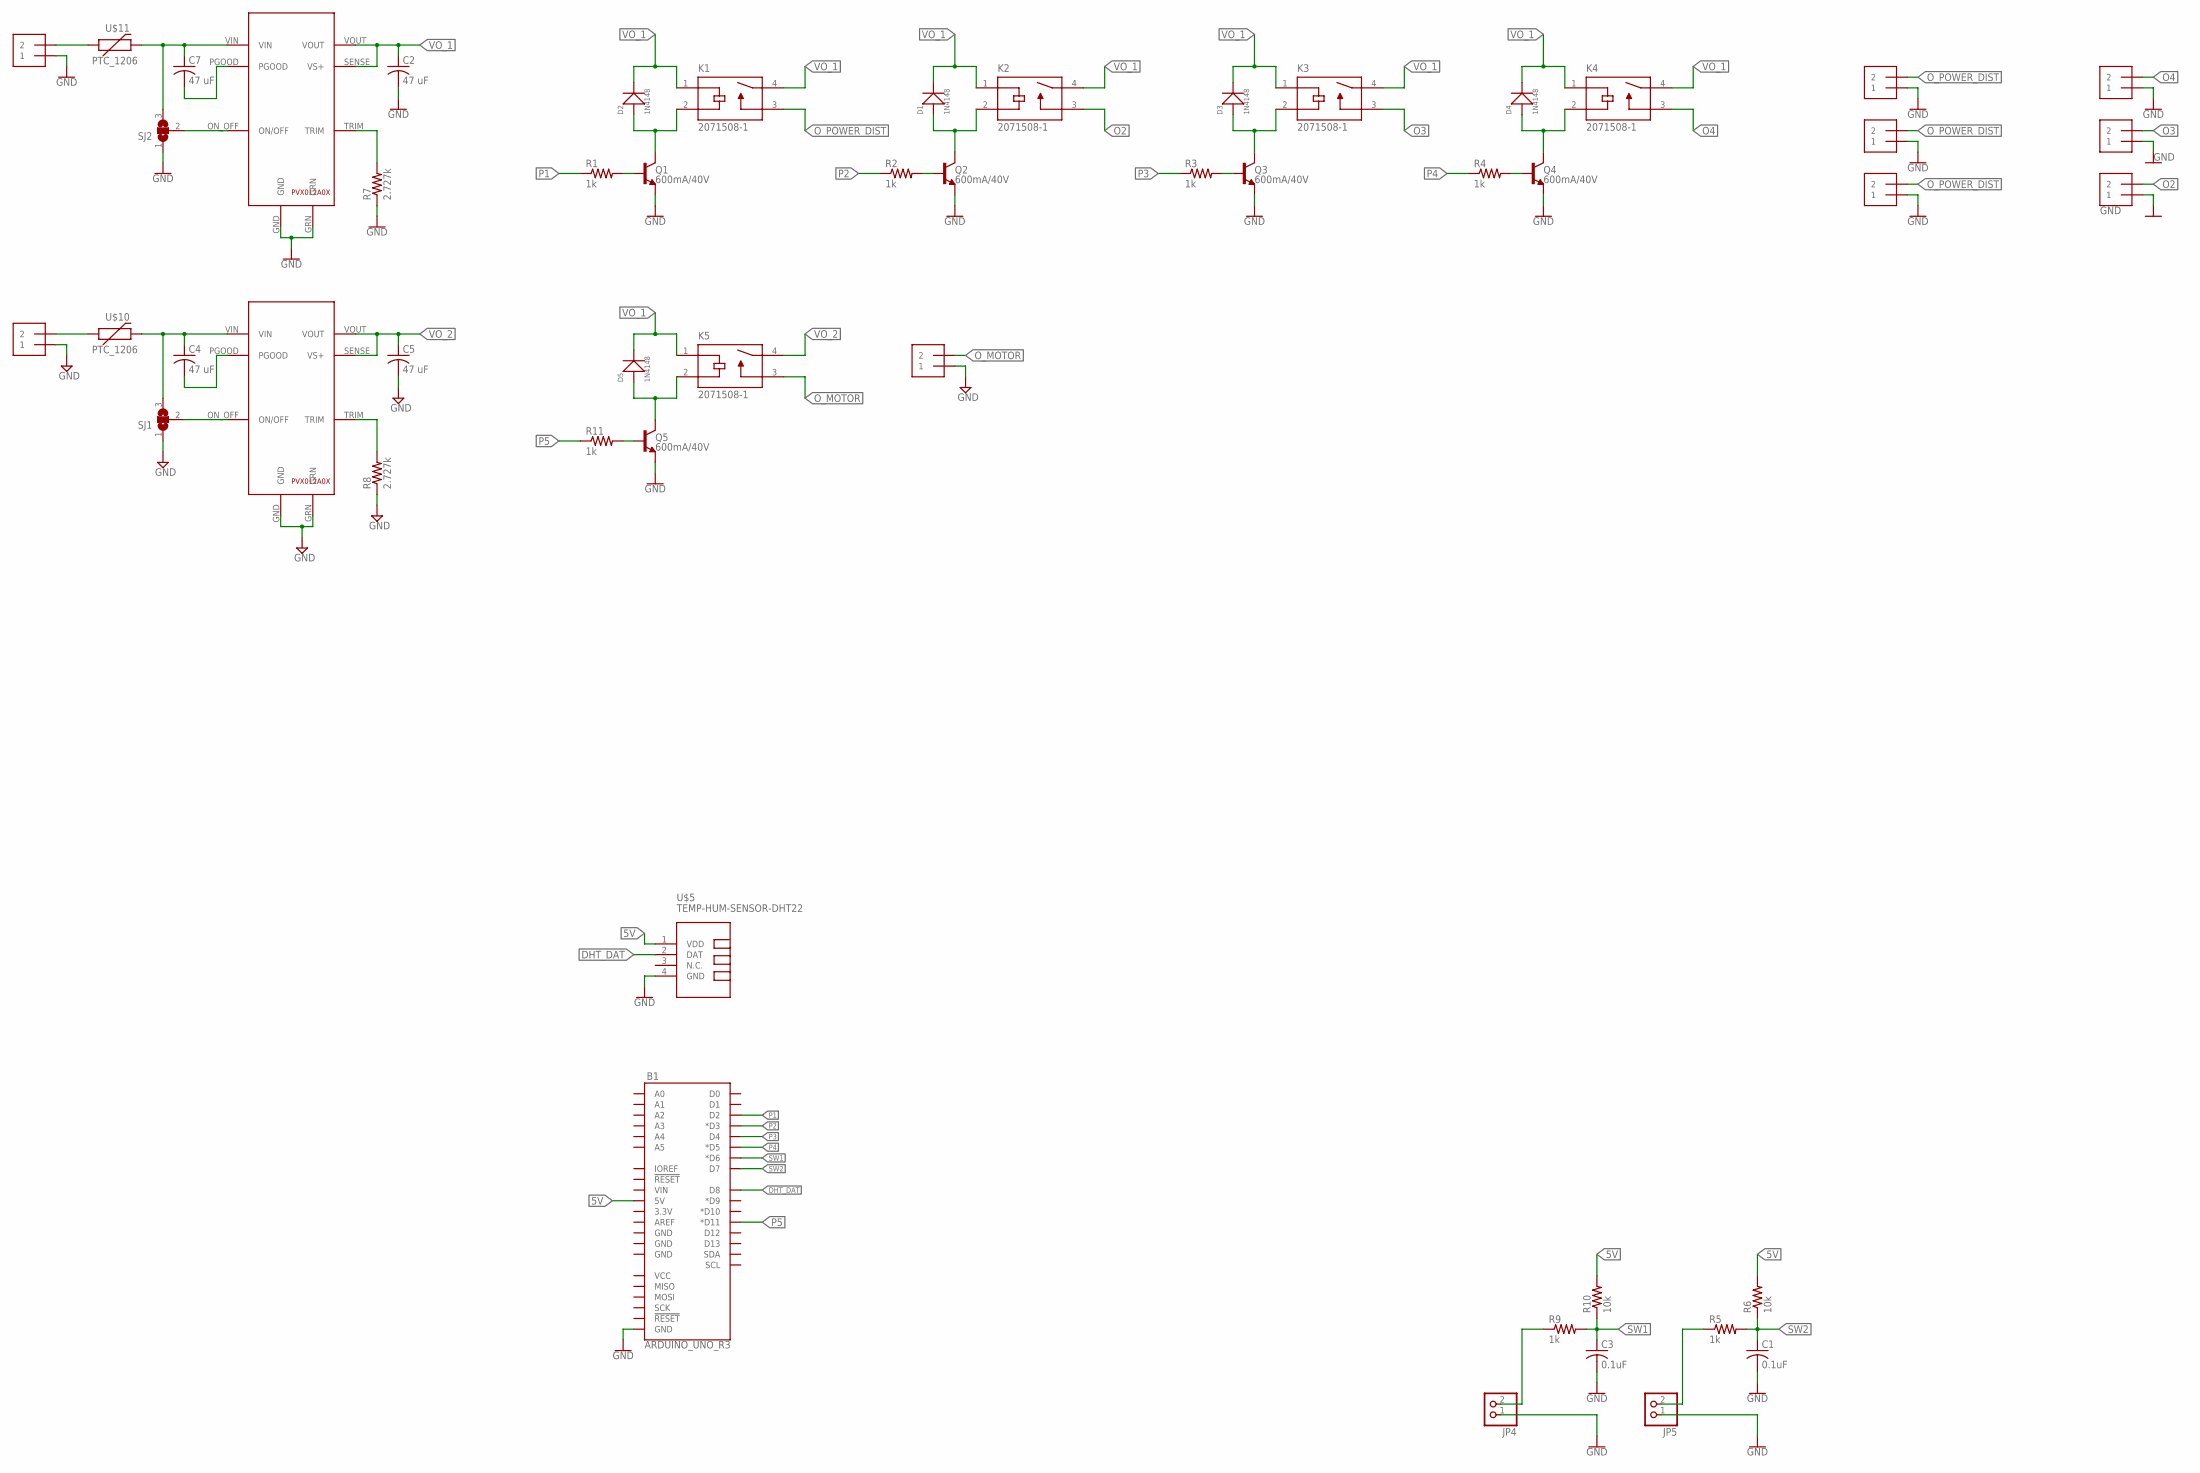
[picture p24: schematic picrocope_hub_v2r1.sch]

Parts:
B1: ARDUINO_UNO_R3; ARDUINO_R3
C1, C3: 0.1uF; C0603
C2, C4, C5, C7: 47 uF; C1210
D1, D2, D3, D4, D5: 1N4148; LL-34
JP4, JP5: PINHD-1X2; 1X02
K1, K2, K3, K4, K5: 2071508-1; RELAY_2071508-1
Q1, Q2, Q3, Q4, Q5: 600mA/40V; SOT23-3
R1, R2, R3, R4, R5, R9, R11: 1k; R0603
R6, R10: 10k; R0603
R7, R8: 2.727k; R0603
SJ1, SJ2: SJ2W; SJ_2
U$1, U$2: PVX012A0XV1; PVX012A0X
U$3, U$4, U$6, U$7, U$8, U$9, U$12, U$13, U$14: MOLEX_0039301022; MINI-FIT_JR_CONN
U$5: TEMP-HUM-SENSOR-DHT22
U$10, U$11: PTC_1206; 1206

Connections:
5V: B1.5V, R6.2, R10.2, U$5.1 (VDD)
DHT_DAT: B1.D8, U$5.2 (DAT)
GND: B1.GND@1 (GND), C1.2, C2.2, C3.2, JP4.1, JP5.1, Q1.2 (E), Q2.2 (E), Q3.2 (E), Q4.2 (E), Q5.2 (E), R7.1, SJ2.1, U$1.GND, U$1.GRN, U$3.P$2 (1), U$5.4 (GND), U$6.P$2 (1), U$7.P$2 (1), U$8.P$2 (1), U$9.P$2 (1), U$12.P$2 (1), U$13.P$2 (1)
GND2: C5.2, R8.1, SJ1.1, U$2.GND, U$2.GRN, U$4.P$2 (1), U$14.P$2 (1)
unnamed: Q1.1 (B), R1.2
unnamed: D2.A (+), K1.2 (COIL2), Q1.3 (C)
unnamed: U$4.P$1 (2), U$10.1
unnamed: JP5.2, R5.1
unnamed: Q2.1 (B), R2.2
unnamed: D1.A (+), K2.2 (COIL2), Q2.3 (C)
unnamed: Q3.1 (B), R3.2
unnamed: D3.A (+), K3.2 (COIL2), Q3.3 (C)
unnamed: Q4.1 (B), R4.2
unnamed: D4.A (+), K4.2 (COIL2), Q4.3 (C)
unnamed: JP4.2, R9.1
unnamed: Q5.1 (B), R11.2
unnamed: C4.2, U$2.PGOOD
unnamed: C7.2, U$1.PGOOD
unnamed: D5.A (+), K5.2 (COIL2), Q5.3 (C)
unnamed: R8.2, U$2.TRIM
unnamed: R7.2, U$1.TRIM
unnamed: SJ1.2, U$2.ON_OFF (ON/OFF)
unnamed: SJ2.2, U$1.ON_OFF (ON/OFF)
unnamed: U$3.P$1 (2), U$11.1
O2: K2.3 (NO), U$7.P$1 (2)
O3: K3.3 (NO), U$8.P$1 (2)
O4: K4.3 (NO), U$9.P$1 (2)
O_MOTOR: K5.3 (NO), U$14.P$1 (2)
O_POWER_DIST: K1.3 (NO), U$6.P$1 (2), U$12.P$1 (2), U$13.P$1 (2)
P1: B1.D2, R1.1
P2: B1.D3 (*D3), R2.1
P3: B1.D4, R3.1
P4: B1.D5 (*D5), R4.1
P5: B1.D11 (*D11), R11.1
SW1: B1.D6 (*D6), C3.1, R9.2, R10.1
SW2: B1.D7, C1.1, R5.2, R6.1
VIN_1: C7.1, SJ2.3, U$1.VIN, U$11.2
VIN_2: C4.1, SJ1.3, U$2.VIN, U$10.2
VO_1: C2.1, D1.C (-), D2.C (-), D3.C (-), D4.C (-), D5.C (-), K1.1 (COIL1), K1.4 (COM), K2.1 (COIL1), K2.4 (COM), K3.1 (COIL1), K3.4 (COM), K4.1 (COIL1), K4.4 (COM), K5.1 (COIL1), U$1.SENSE (VS+), U$1.VOUT
VO_2: C5.1, K5.4 (COM), U$2.SENSE (VS+), U$2.VOUT

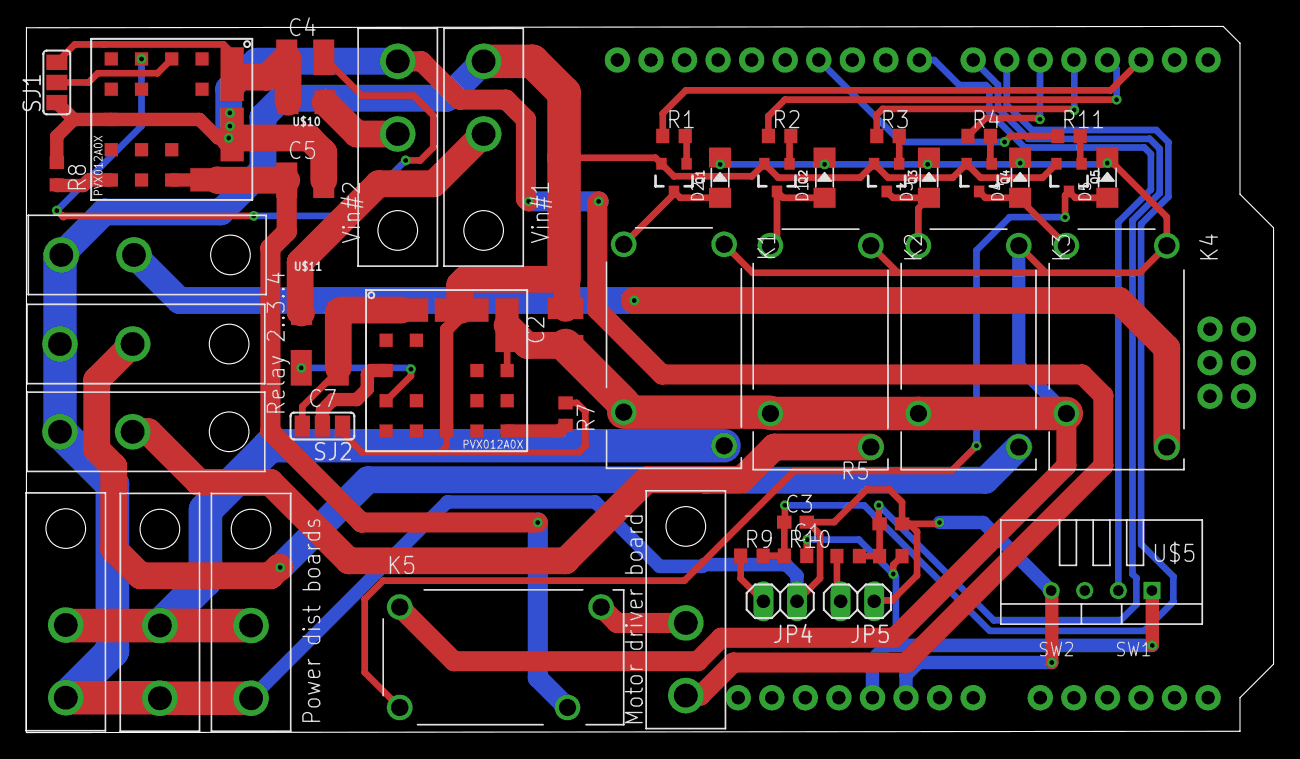
[picture p25: board picrocope_hub_v2r1.brd from above]

Board: 2 copper layers, 94.4 x 53.4 mm, 51 parts (0 on the bottom side), 40 nets.
