braingeneers/picroscope-supplement/PCBs/power_distribution/pinheader_v8/pinheader_v8.brd

## EAGLE design PCBs/power_distribution/pinheader_v8/pinheader_v8.brd (2021-11-16)

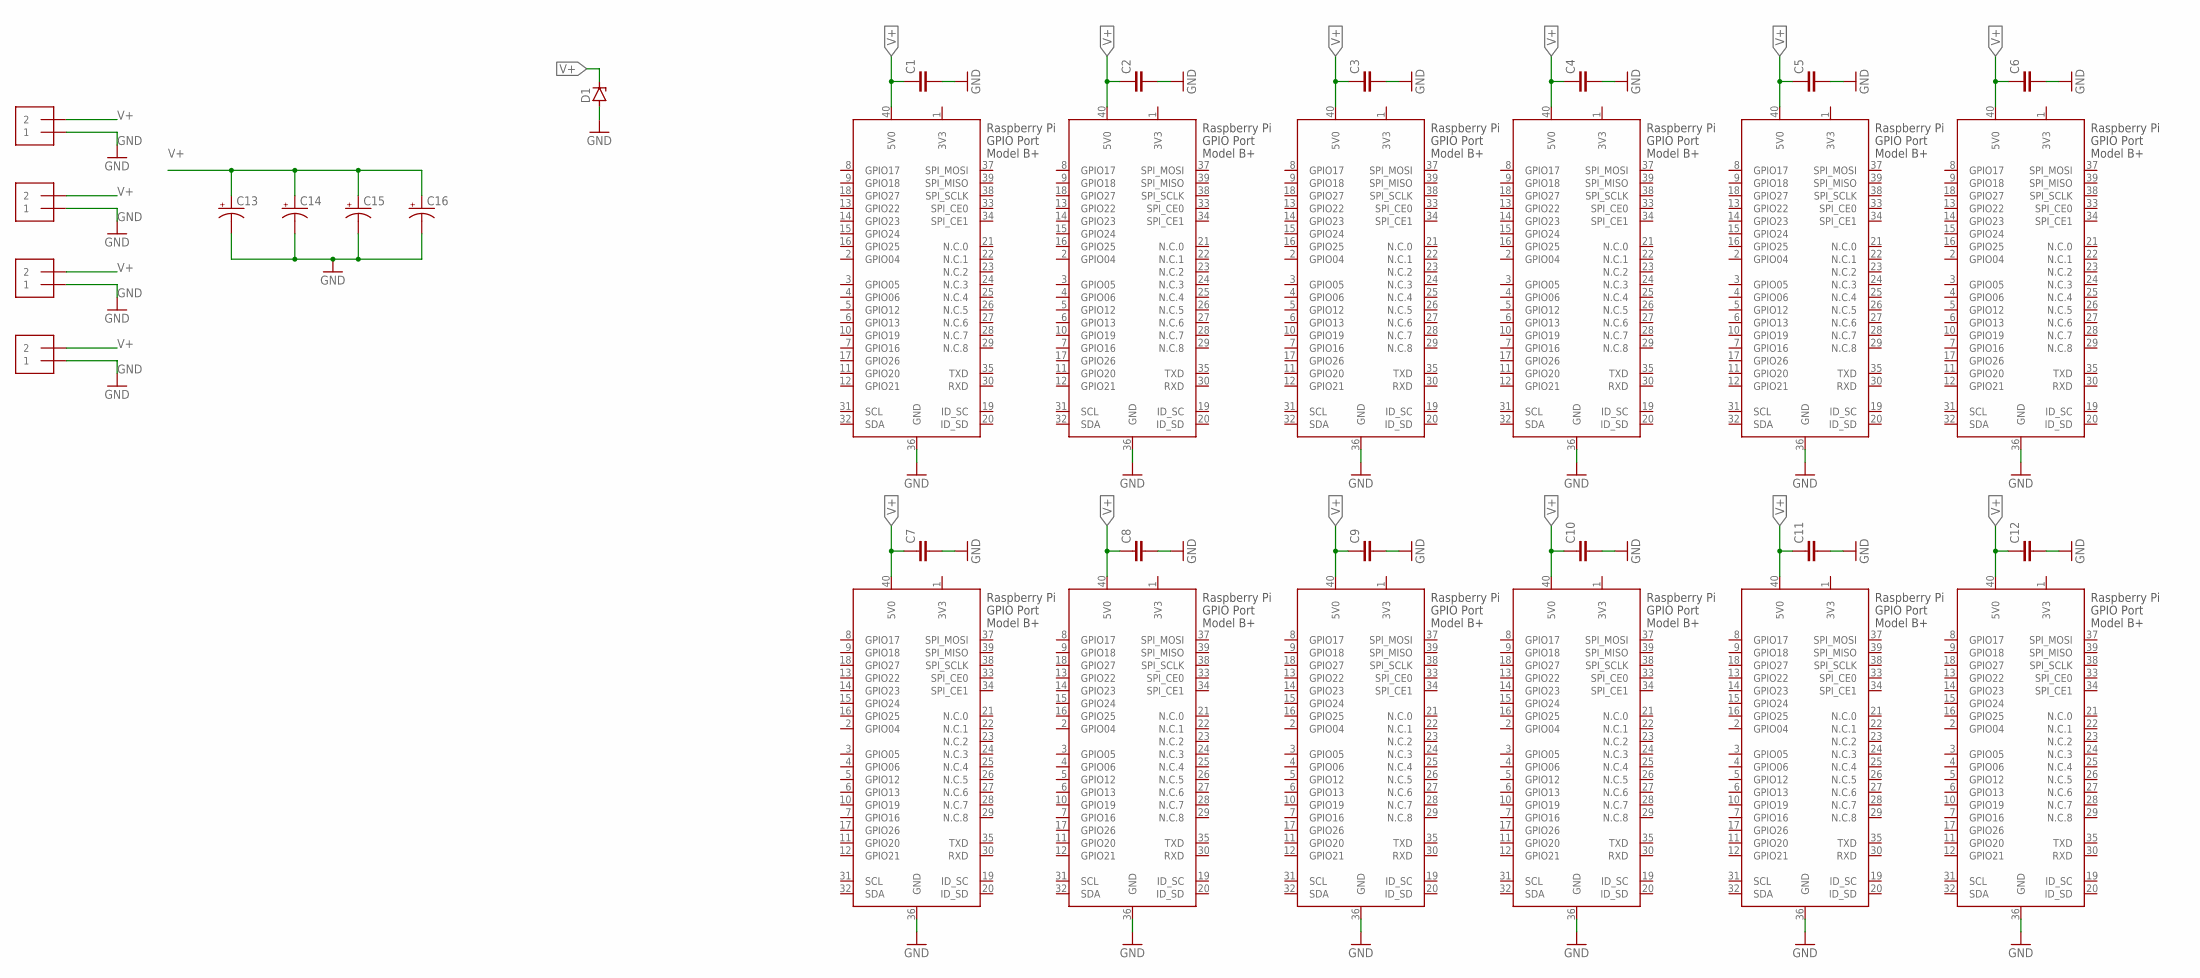
[picture p26: schematic pinheader_v8.sch]

Parts:
C1, C2, C3, C4, C5, C6, C7, C8, C9, C10, C11, C12: C-EUC0603; C0603
C13, C14, C15, C16: CPOL-USE3.5-8; E3,5-8
D1: ZENER-DIODESOT223; SOT223
U$1, U$2, U$3, U$4, U$5, U$6, U$7, U$8, U$9, U$10, U$11, U$12: RASPI_GPIO_B+_PWR; RASPI_GPIO_B+_PIN
U$13, U$14, U$15, U$16: MOLEX_0039301022; MINI-FIT_JR_CONN

Connections:
3V3: U$1.1 (3V3), U$2.1 (3V3), U$3.1 (3V3), U$4.1 (3V3), U$5.1 (3V3), U$6.1 (3V3), U$7.1 (3V3), U$8.1 (3V3), U$9.1 (3V3), U$10.1 (3V3), U$11.1 (3V3), U$12.1 (3V3)
GND: C1.2, C2.2, C3.2, C4.2, C5.2, C6.2, C7.2, C8.2, C9.2, C10.2, C11.2, C12.2, C13.-, C14.-, C15.-, C16.-, D1.1 (A), U$1.36 (GND), U$2.36 (GND), U$3.36 (GND), U$4.36 (GND), U$5.36 (GND), U$6.36 (GND), U$7.36 (GND), U$8.36 (GND), U$9.36 (GND), U$10.36 (GND), U$11.36 (GND), U$12.36 (GND), U$13.P$2 (1), U$14.P$2 (1), U$15.P$2 (1), U$16.P$2 (1)
V+: C1.1, C2.1, C3.1, C4.1, C5.1, C6.1, C7.1, C8.1, C9.1, C10.1, C11.1, C12.1, C13.+, C14.+, C15.+, C16.+, D1.4 (C), U$1.40 (5V0), U$2.40 (5V0), U$3.40 (5V0), U$4.40 (5V0), U$5.40 (5V0), U$6.40 (5V0), U$7.40 (5V0), U$8.40 (5V0), U$9.40 (5V0), U$10.40 (5V0), U$11.40 (5V0), U$12.40 (5V0), U$13.P$1 (2), U$14.P$1 (2), U$15.P$1 (2), U$16.P$1 (2)

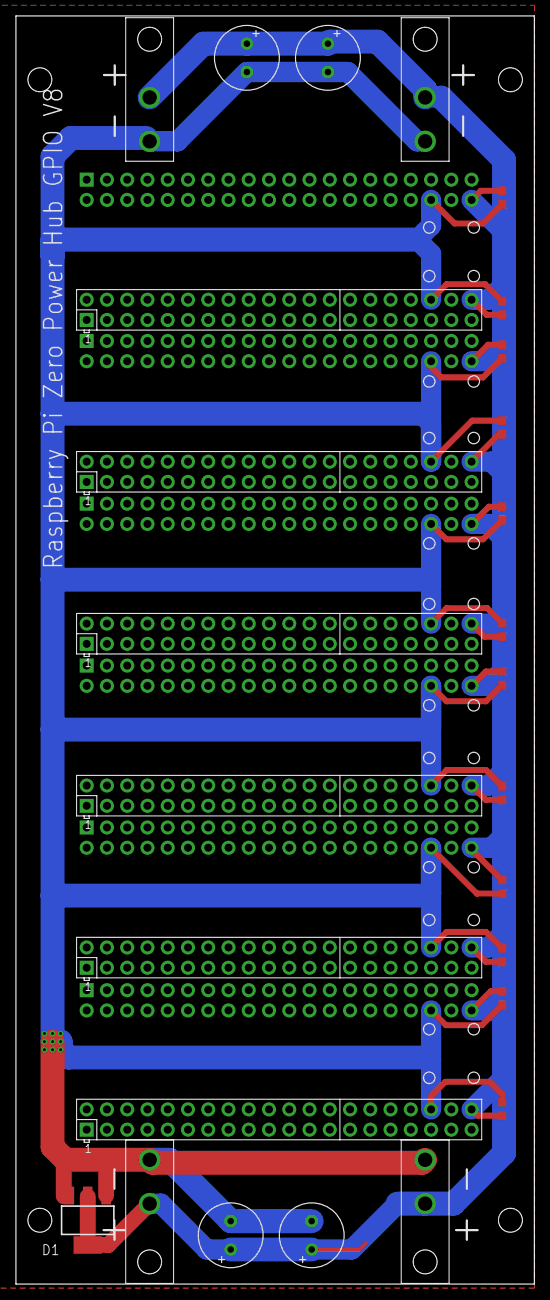
[picture p27: board pinheader_v8.brd from above]

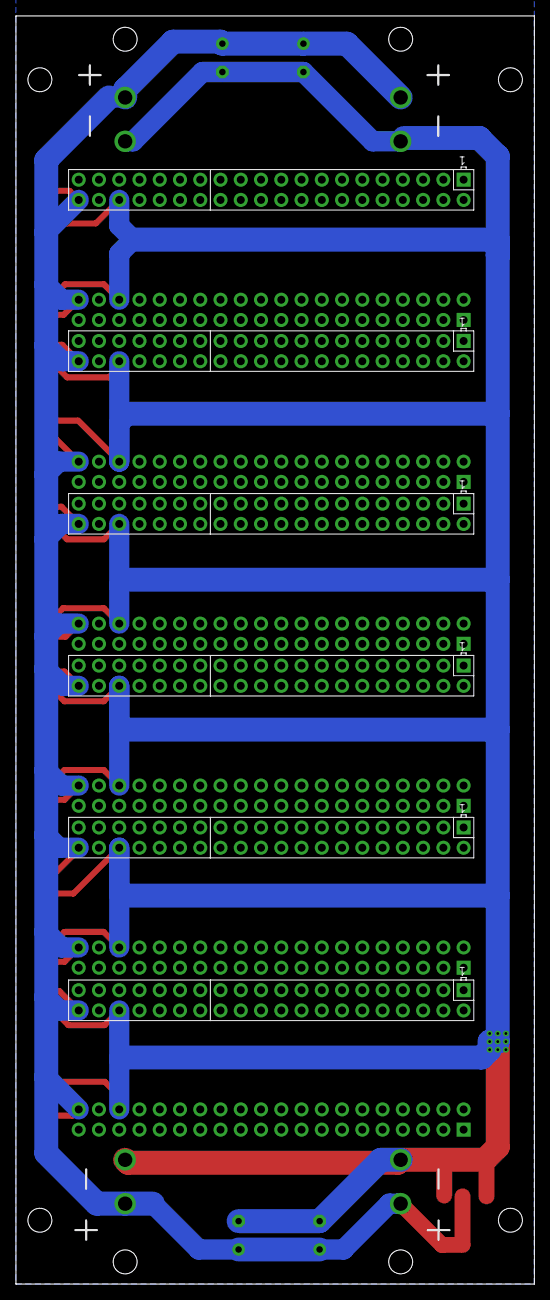
[picture p28: board pinheader_v8.brd from below]

Board: 2 copper layers, 65.0 x 159.0 mm, 33 parts (6 on the bottom side), 3 nets.
