braingeneers/picroscope-supplement/PCBs/below_light/v6/v6.brd

## EAGLE design PCBs/below_light/v6/v6.brd (2021-11-16)

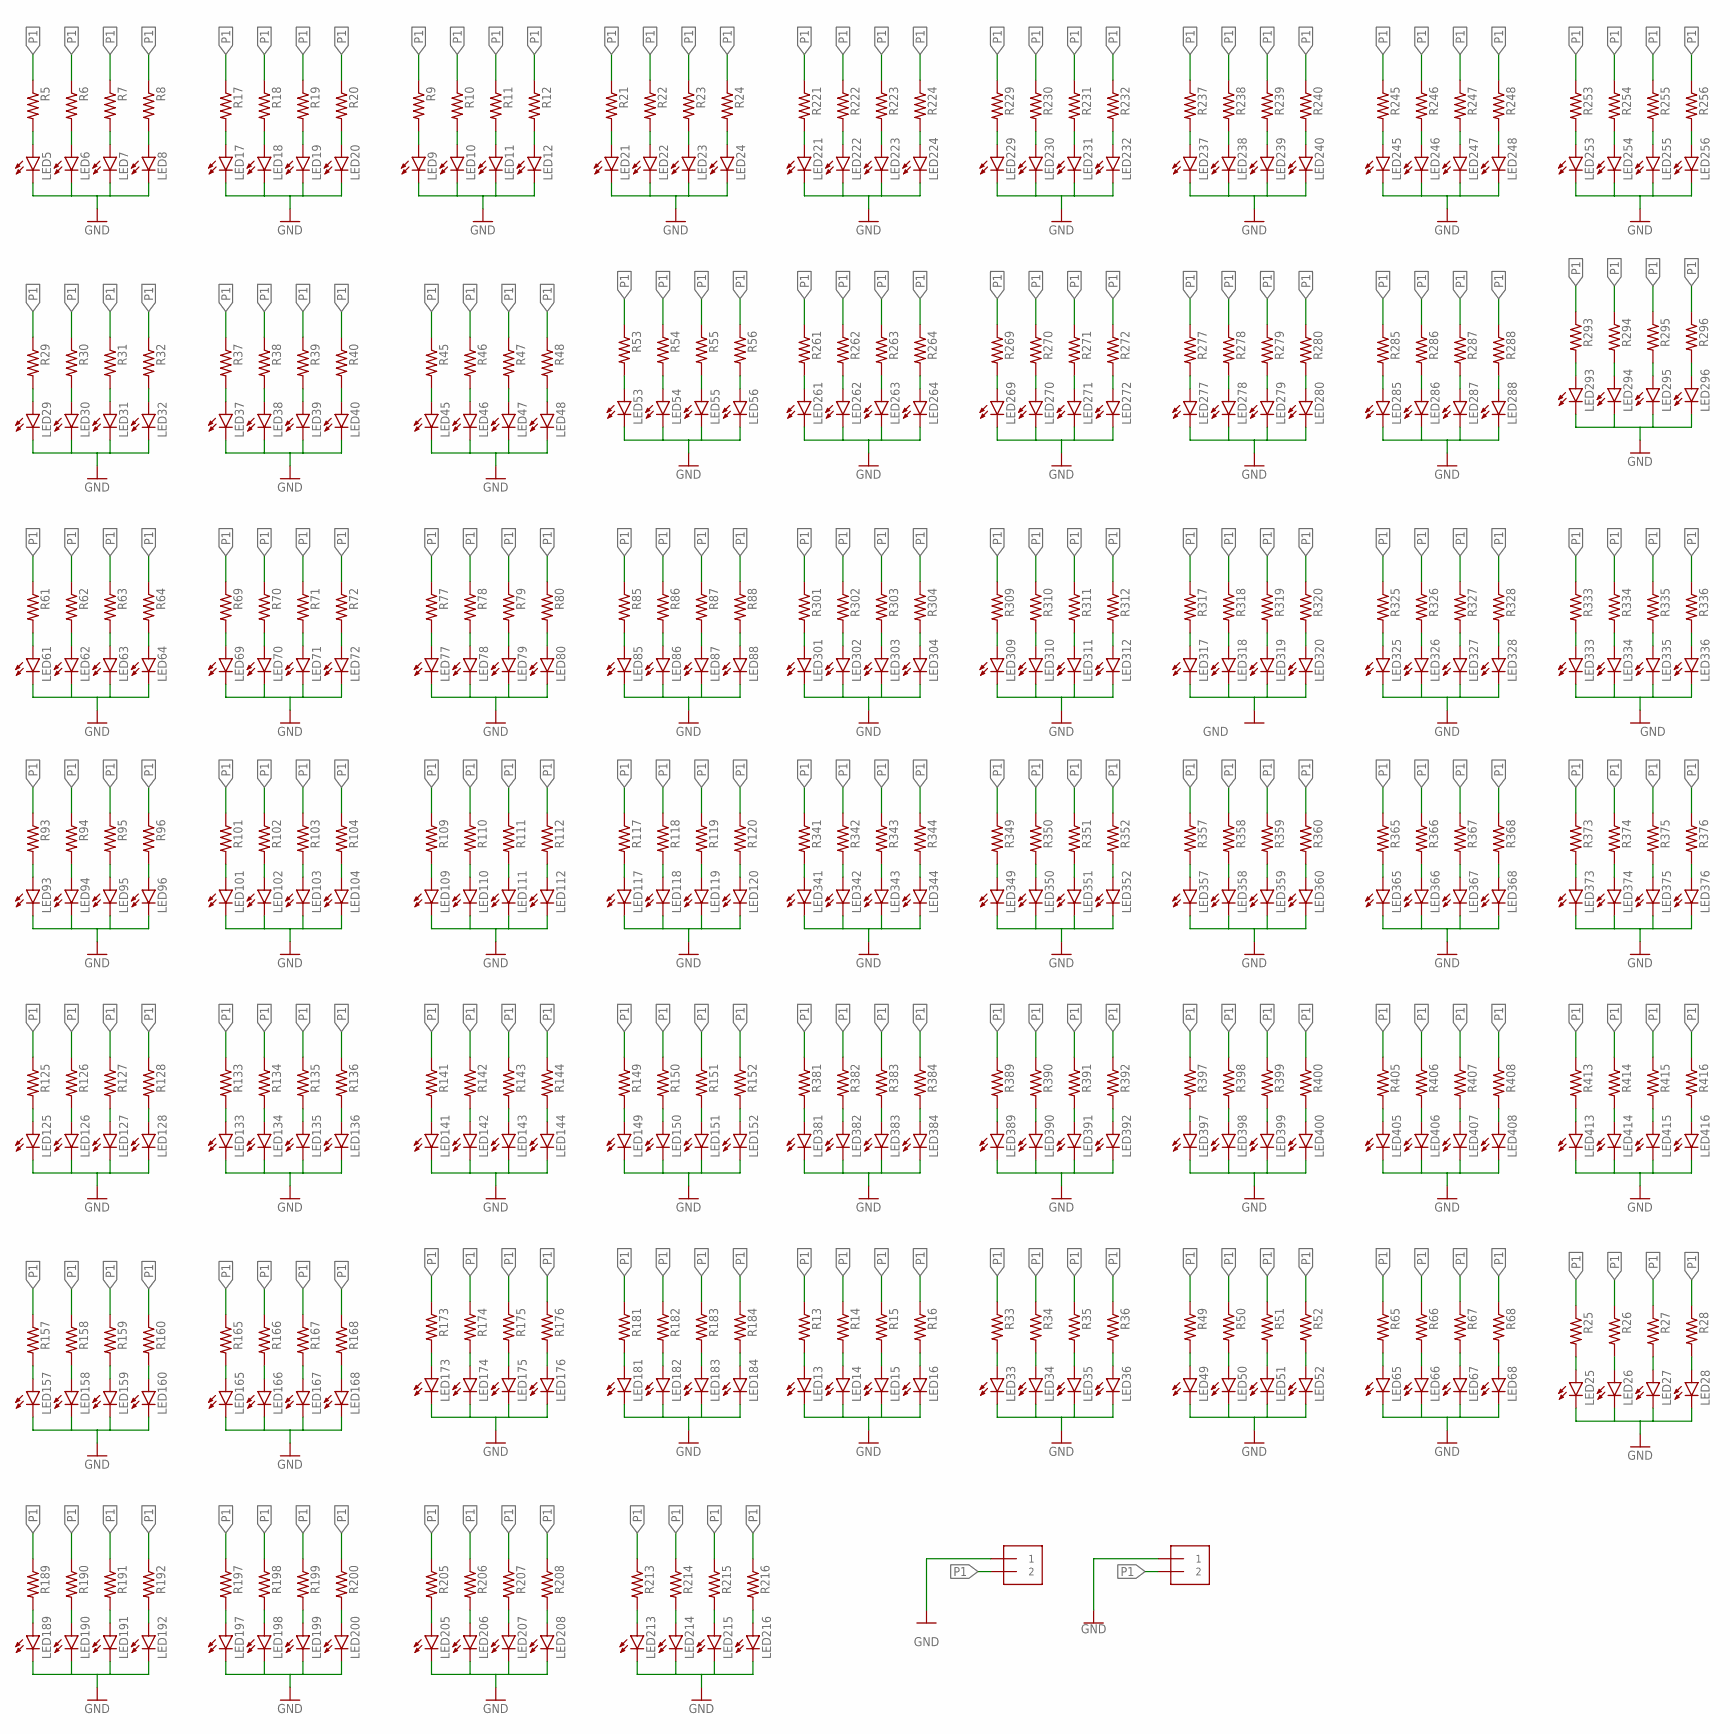
[picture p29: schematic v6.sch]

Parts:
LED5, LED6, LED7, LED8, LED9, LED10, LED11, LED12, LED13, LED14, LED15, LED16, LED17, LED18, LED19, LED20, LED21, LED22, LED23, LED24, LED25, LED26, LED27, LED28, LED29, LED30, LED31, LED32, LED33, LED34, LED35, LED36, LED37, LED38, LED39, LED40, LED45, LED46, LED47, LED48, LED49, LED50, LED51, LED52, LED53, LED54, LED55, LED56, LED61, LED62, LED63, LED64, LED65, LED66, LED67, LED68, LED69, LED70, LED71, LED72, LED77, LED78, LED79, LED80, LED85, LED86, LED87, LED88, LED93, LED94, LED95, LED96, LED101, LED102, LED103, LED104, LED109, LED110, LED111, LED112, LED117, LED118, LED119, LED120, LED125, LED126, LED127, LED128, LED133, LED134, LED135, LED136, LED141, LED142, LED143, LED144, LED149, LED150, LED151, LED152, LED157, LED158, LED159, LED160, LED165, LED166, LED167, LED168, LED173, LED174, LED175, LED176, LED181, LED182, LED183, LED184, LED189, LED190, LED191, LED192, LED197, LED198, LED199, LED200, LED205, LED206, LED207, LED208, LED213, LED214, LED215, LED216, LED221, LED222, LED223, LED224, LED229, LED230, LED231, LED232, LED237, LED238, LED239, LED240, LED245, LED246, LED247, LED248, LED253, LED254, LED255, LED256, LED261, LED262, LED263, LED264, LED269, LED270, LED271, LED272, LED277, LED278, LED279, LED280, LED285, LED286, LED287, LED288, LED293, LED294, LED295, LED296, LED301, LED302, LED303, LED304, LED309, LED310, LED311, LED312, LED317, LED318, LED319, LED320, LED325, LED326, LED327, LED328, LED333, LED334, LED335, LED336, LED341, LED342, LED343, LED344, LED349, LED350, LED351, LED352, LED357, LED358, LED359, LED360, LED365, LED366, LED367, LED368, LED373, LED374, LED375, LED376, LED381, LED382, LED383, LED384, LED389, LED390, LED391, LED392, LED397, LED398, LED399, LED400, LED405, LED406, LED407, LED408, LED413, LED414, LED415, LED416: LEDCHIP-LED0603; CHIP-LED0603
R5, R6, R7, R8, R9, R10, R11, R12, R13, R14, R15, R16, R17, R18, R19, R20, R21, R22, R23, R24, R25, R26, R27, R28, R29, R30, R31, R32, R33, R34, R35, R36, R37, R38, R39, R40, R45, R46, R47, R48, R49, R50, R51, R52, R53, R54, R55, R56, R61, R62, R63, R64, R65, R66, R67, R68, R69, R70, R71, R72, R77, R78, R79, R80, R85, R86, R87, R88, R93, R94, R95, R96, R101, R102, R103, R104, R109, R110, R111, R112, R117, R118, R119, R120, R125, R126, R127, R128, R133, R134, R135, R136, R141, R142, R143, R144, R149, R150, R151, R152, R157, R158, R159, R160, R165, R166, R167, R168, R173, R174, R175, R176, R181, R182, R183, R184, R189, R190, R191, R192, R197, R198, R199, R200, R205, R206, R207, R208, R213, R214, R215, R216, R221, R222, R223, R224, R229, R230, R231, R232, R237, R238, R239, R240, R245, R246, R247, R248, R253, R254, R255, R256, R261, R262, R263, R264, R269, R270, R271, R272, R277, R278, R279, R280, R285, R286, R287, R288, R293, R294, R295, R296, R301, R302, R303, R304, R309, R310, R311, R312, R317, R318, R319, R320, R325, R326, R327, R328, R333, R334, R335, R336, R341, R342, R343, R344, R349, R350, R351, R352, R357, R358, R359, R360, R365, R366, R367, R368, R373, R374, R375, R376, R381, R382, R383, R384, R389, R390, R391, R392, R397, R398, R399, R400, R405, R406, R407, R408, R413, R414, R415, R416: R-US_R0603; R0603
U$1, U$2: MOLEX_0039301022; MINI-FIT_JR_CONN

Connections:
GNDSSS: LED5.C, LED6.C, LED7.C, LED8.C, LED9.C, LED10.C, LED11.C, LED12.C, LED13.C, LED14.C, LED15.C, LED16.C, LED17.C, LED18.C, LED19.C, LED20.C, LED21.C, LED22.C, LED23.C, LED24.C, LED25.C, LED26.C, LED27.C, LED28.C, LED29.C, LED30.C, LED31.C, LED32.C, LED33.C, LED34.C, LED35.C, LED36.C, LED37.C, LED38.C, LED39.C, LED40.C, LED45.C, LED46.C, LED47.C, LED48.C, LED49.C, LED50.C, LED51.C, LED52.C, LED53.C, LED54.C, LED55.C, LED56.C, LED61.C, LED62.C, LED63.C, LED64.C, LED65.C, LED66.C, LED67.C, LED68.C, LED69.C, LED70.C, LED71.C, LED72.C, LED77.C, LED78.C, LED79.C, LED80.C, LED85.C, LED86.C, LED87.C, LED88.C, LED93.C, LED94.C, LED95.C, LED96.C, LED101.C, LED102.C, LED103.C, LED104.C, LED109.C, LED110.C, LED111.C, LED112.C, LED117.C, LED118.C, LED119.C, LED120.C, LED125.C, LED126.C, LED127.C, LED128.C, LED133.C, LED134.C, LED135.C, LED136.C, LED141.C, LED142.C, LED143.C, LED144.C, LED149.C, LED150.C, LED151.C, LED152.C, LED157.C, LED158.C, LED159.C, LED160.C, LED165.C, LED166.C, LED167.C, LED168.C, LED173.C, LED174.C, LED175.C, LED176.C, LED181.C, LED182.C, LED183.C, LED184.C, LED189.C, LED190.C, LED191.C, LED192.C, LED197.C, LED198.C, LED199.C, LED200.C, LED205.C, LED206.C, LED207.C, LED208.C, LED213.C, LED214.C, LED215.C, LED216.C, LED221.C, LED222.C, LED223.C, LED224.C, LED229.C, LED230.C, LED231.C, LED232.C, LED237.C, LED238.C, LED239.C, LED240.C, LED245.C, LED246.C, LED247.C, LED248.C, LED253.C, LED254.C, LED255.C, LED256.C, LED261.C, LED262.C, LED263.C, LED264.C, LED269.C, LED270.C, LED271.C, LED272.C, LED277.C, LED278.C, LED279.C, LED280.C, LED285.C, LED286.C, LED287.C, LED288.C, LED293.C, LED294.C, LED295.C, LED296.C, LED301.C, LED302.C, LED303.C, LED304.C, LED309.C, LED310.C, LED311.C, LED312.C, LED317.C, LED318.C, LED319.C, LED320.C, LED325.C, LED326.C, LED327.C, LED328.C, LED333.C, LED334.C, LED335.C, LED336.C, LED341.C, LED342.C, LED343.C, LED344.C, LED349.C, LED350.C, LED351.C, LED352.C, LED357.C, LED358.C, LED359.C, LED360.C, LED365.C, LED366.C, LED367.C, LED368.C, LED373.C, LED374.C, LED375.C, LED376.C, LED381.C, LED382.C, LED383.C, LED384.C, LED389.C, LED390.C, LED391.C, LED392.C, LED397.C, LED398.C, LED399.C, LED400.C, LED405.C, LED406.C, LED407.C, LED408.C, LED413.C, LED414.C, LED415.C, LED416.C, U$1.P$2 (1), U$2.P$2 (1)
unnamed: LED5.A, R5.2
unnamed: LED6.A, R6.2
unnamed: LED7.A, R7.2
unnamed: LED8.A, R8.2
unnamed: LED9.A, R9.2
unnamed: LED10.A, R10.2
unnamed: LED11.A, R11.2
unnamed: LED12.A, R12.2
unnamed: LED13.A, R13.2
unnamed: LED14.A, R14.2
unnamed: LED15.A, R15.2
unnamed: LED16.A, R16.2
unnamed: LED17.A, R17.2
unnamed: LED18.A, R18.2
unnamed: LED19.A, R19.2
unnamed: LED20.A, R20.2
unnamed: LED21.A, R21.2
unnamed: LED22.A, R22.2
unnamed: LED23.A, R23.2
unnamed: LED24.A, R24.2
unnamed: LED25.A, R25.2
unnamed: LED26.A, R26.2
unnamed: LED27.A, R27.2
unnamed: LED28.A, R28.2
unnamed: LED29.A, R29.2
unnamed: LED30.A, R30.2
unnamed: LED31.A, R31.2
unnamed: LED32.A, R32.2
unnamed: LED33.A, R33.2
unnamed: LED34.A, R34.2
unnamed: LED35.A, R35.2
unnamed: LED36.A, R36.2
unnamed: LED37.A, R37.2
unnamed: LED38.A, R38.2
unnamed: LED39.A, R39.2
unnamed: LED40.A, R40.2
unnamed: LED45.A, R45.2
unnamed: LED46.A, R46.2
unnamed: LED47.A, R47.2
unnamed: LED48.A, R48.2
unnamed: LED49.A, R49.2
unnamed: LED50.A, R50.2
unnamed: LED51.A, R51.2
unnamed: LED52.A, R52.2
unnamed: LED53.A, R53.2
unnamed: LED54.A, R54.2
unnamed: LED55.A, R55.2
unnamed: LED56.A, R56.2
unnamed: LED61.A, R61.2
unnamed: LED62.A, R62.2
unnamed: LED63.A, R63.2
unnamed: LED64.A, R64.2
unnamed: LED65.A, R65.2
unnamed: LED66.A, R66.2
unnamed: LED67.A, R67.2
unnamed: LED68.A, R68.2
unnamed: LED69.A, R69.2
unnamed: LED70.A, R70.2
unnamed: LED71.A, R71.2
unnamed: LED72.A, R72.2
unnamed: LED77.A, R77.2
unnamed: LED78.A, R78.2
unnamed: LED79.A, R79.2
unnamed: LED80.A, R80.2
unnamed: LED85.A, R85.2
unnamed: LED86.A, R86.2
unnamed: LED87.A, R87.2
unnamed: LED88.A, R88.2
unnamed: LED93.A, R93.2
unnamed: LED94.A, R94.2
unnamed: LED95.A, R95.2
unnamed: LED96.A, R96.2
unnamed: LED101.A, R101.2
unnamed: LED102.A, R102.2
unnamed: LED103.A, R103.2
unnamed: LED104.A, R104.2
unnamed: LED109.A, R109.2
unnamed: LED110.A, R110.2
unnamed: LED111.A, R111.2
unnamed: LED112.A, R112.2
unnamed: LED117.A, R117.2
unnamed: LED118.A, R118.2
unnamed: LED119.A, R119.2
unnamed: LED120.A, R120.2
unnamed: LED125.A, R125.2
unnamed: LED126.A, R126.2
unnamed: LED127.A, R127.2
unnamed: LED128.A, R128.2
unnamed: LED133.A, R133.2
unnamed: LED134.A, R134.2
unnamed: LED135.A, R135.2
unnamed: LED136.A, R136.2
unnamed: LED141.A, R141.2
unnamed: LED142.A, R142.2
unnamed: LED143.A, R143.2
unnamed: LED144.A, R144.2
unnamed: LED149.A, R149.2
unnamed: LED150.A, R150.2
unnamed: LED151.A, R151.2
unnamed: LED152.A, R152.2
unnamed: LED157.A, R157.2
unnamed: LED158.A, R158.2
unnamed: LED159.A, R159.2
unnamed: LED160.A, R160.2
unnamed: LED165.A, R165.2
unnamed: LED166.A, R166.2
unnamed: LED167.A, R167.2
unnamed: LED168.A, R168.2
unnamed: LED173.A, R173.2
unnamed: LED174.A, R174.2
unnamed: LED175.A, R175.2
unnamed: LED176.A, R176.2
unnamed: LED181.A, R181.2
unnamed: LED182.A, R182.2
unnamed: LED183.A, R183.2
unnamed: LED184.A, R184.2
unnamed: LED189.A, R189.2
unnamed: LED190.A, R190.2
unnamed: LED191.A, R191.2
unnamed: LED192.A, R192.2
unnamed: LED197.A, R197.2
unnamed: LED198.A, R198.2
unnamed: LED199.A, R199.2
unnamed: LED200.A, R200.2
unnamed: LED205.A, R205.2
unnamed: LED206.A, R206.2
unnamed: LED207.A, R207.2
unnamed: LED208.A, R208.2
unnamed: LED213.A, R213.2
unnamed: LED214.A, R214.2
unnamed: LED215.A, R215.2
unnamed: LED216.A, R216.2
unnamed: LED221.A, R221.2
unnamed: LED222.A, R222.2
unnamed: LED223.A, R223.2
unnamed: LED224.A, R224.2
unnamed: LED229.A, R229.2
unnamed: LED230.A, R230.2
unnamed: LED231.A, R231.2
unnamed: LED232.A, R232.2
unnamed: LED237.A, R237.2
unnamed: LED238.A, R238.2
unnamed: LED239.A, R239.2
unnamed: LED240.A, R240.2
unnamed: LED245.A, R245.2
unnamed: LED246.A, R246.2
unnamed: LED247.A, R247.2
unnamed: LED248.A, R248.2
unnamed: LED253.A, R253.2
unnamed: LED254.A, R254.2
unnamed: LED255.A, R255.2
unnamed: LED256.A, R256.2
unnamed: LED261.A, R261.2
unnamed: LED262.A, R262.2
unnamed: LED263.A, R263.2
unnamed: LED264.A, R264.2
unnamed: LED269.A, R269.2
unnamed: LED270.A, R270.2
unnamed: LED271.A, R271.2
unnamed: LED272.A, R272.2
unnamed: LED277.A, R277.2
unnamed: LED278.A, R278.2
unnamed: LED279.A, R279.2
unnamed: LED280.A, R280.2
unnamed: LED285.A, R285.2
unnamed: LED286.A, R286.2
unnamed: LED287.A, R287.2
unnamed: LED288.A, R288.2
unnamed: LED293.A, R293.2
unnamed: LED294.A, R294.2
unnamed: LED295.A, R295.2
unnamed: LED296.A, R296.2
unnamed: LED301.A, R301.2
unnamed: LED302.A, R302.2
unnamed: LED303.A, R303.2
unnamed: LED304.A, R304.2
unnamed: LED309.A, R309.2
unnamed: LED310.A, R310.2
unnamed: LED311.A, R311.2
unnamed: LED312.A, R312.2
unnamed: LED317.A, R317.2
unnamed: LED318.A, R318.2
unnamed: LED319.A, R319.2
unnamed: LED320.A, R320.2
unnamed: LED325.A, R325.2
unnamed: LED326.A, R326.2
unnamed: LED327.A, R327.2
unnamed: LED328.A, R328.2
unnamed: LED333.A, R333.2
unnamed: LED334.A, R334.2
unnamed: LED335.A, R335.2
unnamed: LED336.A, R336.2
unnamed: LED341.A, R341.2
unnamed: LED342.A, R342.2
unnamed: LED343.A, R343.2
unnamed: LED344.A, R344.2
unnamed: LED349.A, R349.2
unnamed: LED350.A, R350.2
unnamed: LED351.A, R351.2
unnamed: LED352.A, R352.2
unnamed: LED357.A, R357.2
unnamed: LED358.A, R358.2
unnamed: LED359.A, R359.2
unnamed: LED360.A, R360.2
unnamed: LED365.A, R365.2
unnamed: LED366.A, R366.2
unnamed: LED367.A, R367.2
unnamed: LED368.A, R368.2
unnamed: LED373.A, R373.2
unnamed: LED374.A, R374.2
unnamed: LED375.A, R375.2
unnamed: LED376.A, R376.2
unnamed: LED381.A, R381.2
unnamed: LED382.A, R382.2
unnamed: LED383.A, R383.2
unnamed: LED384.A, R384.2
unnamed: LED389.A, R389.2
unnamed: LED390.A, R390.2
unnamed: LED391.A, R391.2
unnamed: LED392.A, R392.2
unnamed: LED397.A, R397.2
unnamed: LED398.A, R398.2
unnamed: LED399.A, R399.2
unnamed: LED400.A, R400.2
unnamed: LED405.A, R405.2
unnamed: LED406.A, R406.2
unnamed: LED407.A, R407.2
unnamed: LED408.A, R408.2
unnamed: LED413.A, R413.2
unnamed: LED414.A, R414.2
unnamed: LED415.A, R415.2
unnamed: LED416.A, R416.2
P1: R5.1, R6.1, R7.1, R8.1, R9.1, R10.1, R11.1, R12.1, R13.1, R14.1, R15.1, R16.1, R17.1, R18.1, R19.1, R20.1, R21.1, R22.1, R23.1, R24.1, R25.1, R26.1, R27.1, R28.1, R29.1, R30.1, R31.1, R32.1, R33.1, R34.1, R35.1, R36.1, R37.1, R38.1, R39.1, R40.1, R45.1, R46.1, R47.1, R48.1, R49.1, R50.1, R51.1, R52.1, R53.1, R54.1, R55.1, R56.1, R61.1, R62.1, R63.1, R64.1, R65.1, R66.1, R67.1, R68.1, R69.1, R70.1, R71.1, R72.1, R77.1, R78.1, R79.1, R80.1, R85.1, R86.1, R87.1, R88.1, R93.1, R94.1, R95.1, R96.1, R101.1, R102.1, R103.1, R104.1, R109.1, R110.1, R111.1, R112.1, R117.1, R118.1, R119.1, R120.1, R125.1, R126.1, R127.1, R128.1, R133.1, R134.1, R135.1, R136.1, R141.1, R142.1, R143.1, R144.1, R149.1, R150.1, R151.1, R152.1, R157.1, R158.1, R159.1, R160.1, R165.1, R166.1, R167.1, R168.1, R173.1, R174.1, R175.1, R176.1, R181.1, R182.1, R183.1, R184.1, R189.1, R190.1, R191.1, R192.1, R197.1, R198.1, R199.1, R200.1, R205.1, R206.1, R207.1, R208.1, R213.1, R214.1, R215.1, R216.1, R221.1, R222.1, R223.1, R224.1, R229.1, R230.1, R231.1, R232.1, R237.1, R238.1, R239.1, R240.1, R245.1, R246.1, R247.1, R248.1, R253.1, R254.1, R255.1, R256.1, R261.1, R262.1, R263.1, R264.1, R269.1, R270.1, R271.1, R272.1, R277.1, R278.1, R279.1, R280.1, R285.1, R286.1, R287.1, R288.1, R293.1, R294.1, R295.1, R296.1, R301.1, R302.1, R303.1, R304.1, R309.1, R310.1, R311.1, R312.1, R317.1, R318.1, R319.1, R320.1, R325.1, R326.1, R327.1, R328.1, R333.1, R334.1, R335.1, R336.1, R341.1, R342.1, R343.1, R344.1, R349.1, R350.1, R351.1, R352.1, R357.1, R358.1, R359.1, R360.1, R365.1, R366.1, R367.1, R368.1, R373.1, R374.1, R375.1, R376.1, R381.1, R382.1, R383.1, R384.1, R389.1, R390.1, R391.1, R392.1, R397.1, R398.1, R399.1, R400.1, R405.1, R406.1, R407.1, R408.1, R413.1, R414.1, R415.1, R416.1, U$1.P$1 (2), U$2.P$1 (2)

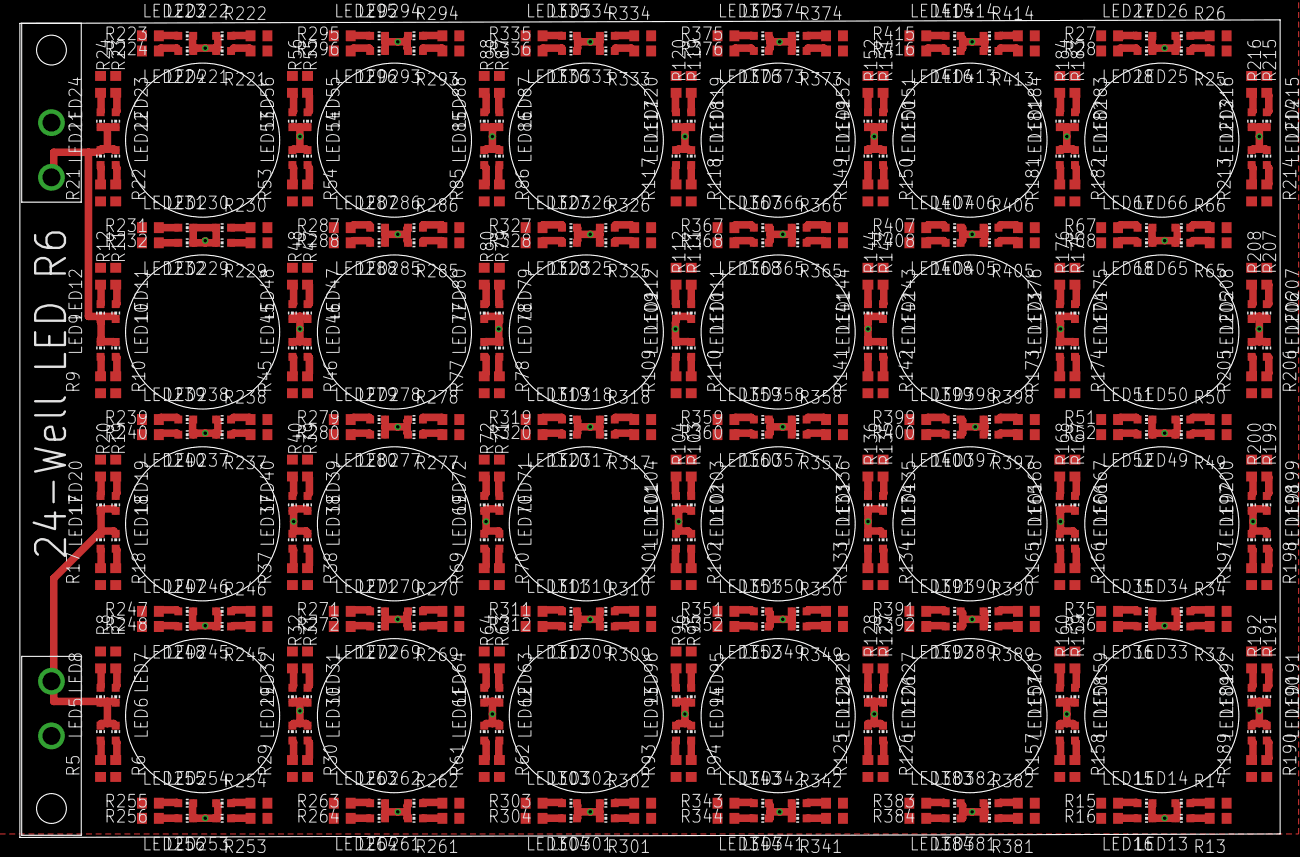
[picture p30: board v6.brd from above]

Board: 2 copper layers, 126.8 x 82.2 mm, 466 parts (0 on the bottom side), 234 nets.
