braingeneers/picroscope-supplement/(commit log)

2021-12-13 Picroscope CAD files
    [CameraInsert_v24 v1.stl, Limit switch stopper again v3.stl, base.stl, camerarow1.stl, elevator double limit switch v1.stl, led1.stl, led2.stl, picroscope_wide_v7.stl]
2022-03-15 added v1 of uno shield for connecting XY limit switches and motor encoders
    [shield board.brd, shield board.sch]
2022-03-15 added debounce to sch, about to delete and add back as design block
    [shield board.brd, shield board.sch]
2022-03-15 jumper togglable debounce circuit added for encoders
    [shield board.brd, shield board.sch]
2022-03-17 moved components to bottom layer
    [shield board.brd]
2022-03-18 moved components and wires back to top layer
    [shield board.brd]
2022-03-18 made new version optimized for cnc routing
    [shield board.brd, shield board.sch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]
2022-03-25 realized i only need one switch port, about to redesign
    [shield board.brd, shield board.sch]
2022-03-25 routed new board design
    [shield board.brd, shield board.sch]
2022-04-15 fixed orientation of molex connectors in encoder shield
    [shield board.brd]
2022-04-16 moved molex connectors further out to the edge
    [shield board.brd]
2022-05-13 updated overheadlight eaglefile
    [24v5_bom.xlsx, 24v5_pnp.xlsx, pannel_24_v5.brd, pannel_24_v5.csv, pannel_24_v5.sch]
2022-06-13 added encoder board
    [BOM.csv, shield board_top_bom.csv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]
2022-08-22 Delete Limit switch stopper again v3.stl
    old peice
    [Limit switch stopper again v3.stl]
2022-08-23 CAD update Aug 22 2022
    [Elevator.stl, XY_X_axis_adjust.stl, XY_Y_axis_adjust.stl, XY_plate_holder.stl, base_linear.stl, camera_clip.stl, camera_holder_left.stl, camera_holder_middle_left.stl]
2022-08-23 CAD purge 1
    [base.stl, led1.stl, led2.stl, picroscope_wide_v7.stl, xystage_og.stl]
2022-08-23 added new version of encoder board
    [shield board.brd]
